LukeRJamieson/long-range-remote/previews/control_lite_3d_iso_back.png

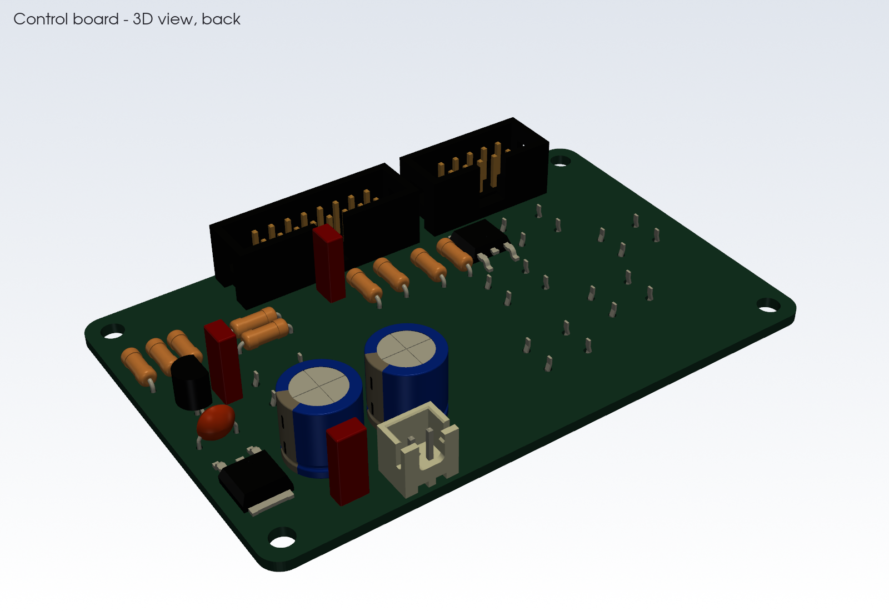
previews/control_lite_3d_iso_back.png
