LukeRJamieson/long-range-remote/previews/led_head_lite_3d_top.png

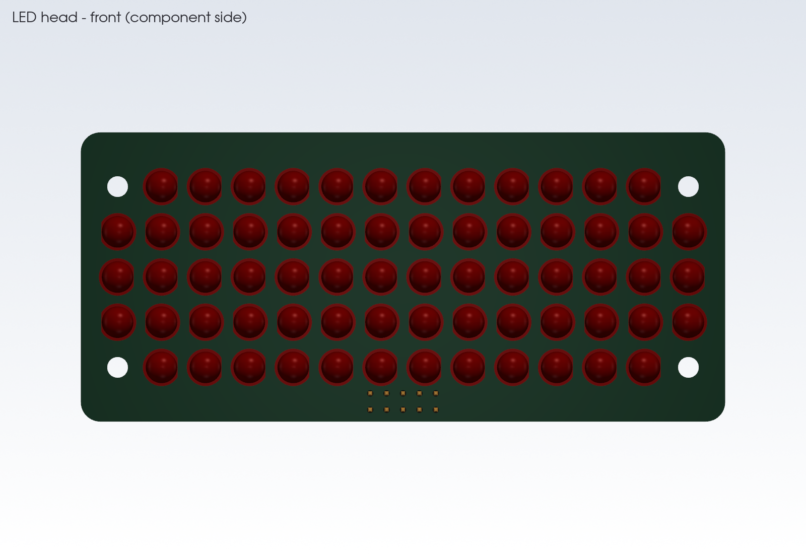
previews/led_head_lite_3d_top.png
