LukeRJamieson/long-range-remote/housing/previews/lite_bottom.png

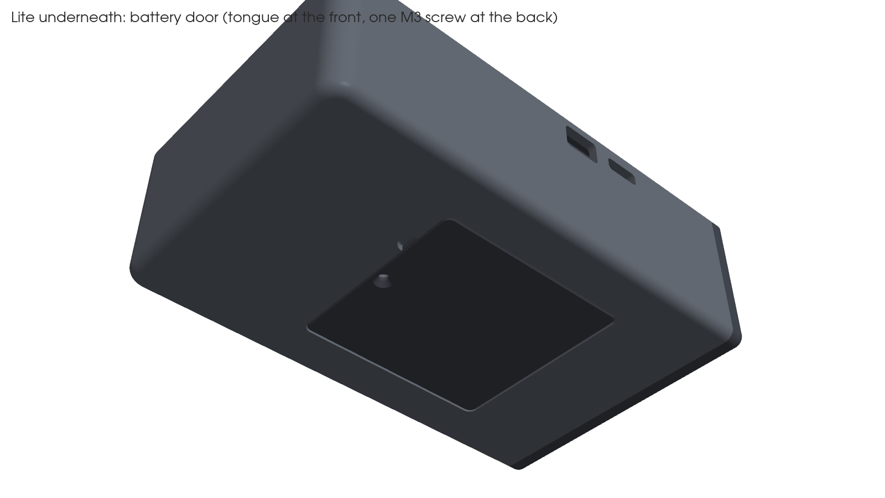
housing/previews/lite_bottom.png
