LukeRJamieson/long-range-remote/housing/previews/lite_display_buttons.png

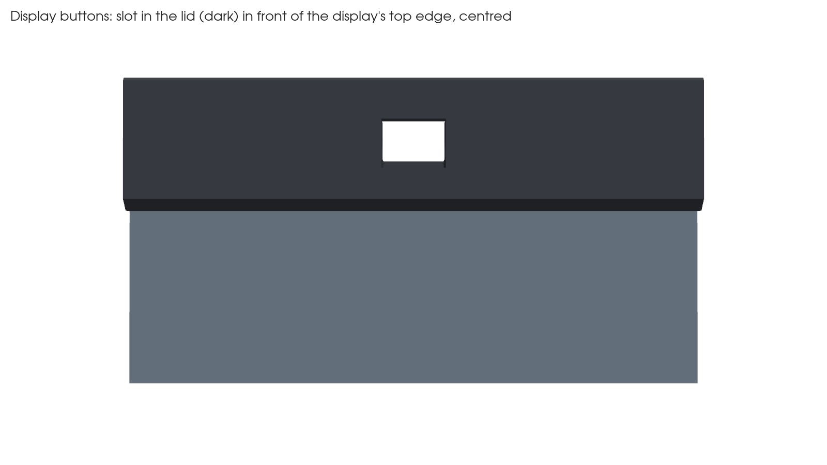
housing/previews/lite_display_buttons.png
