LukeRJamieson/long-range-remote/housing/previews/lite_exploded.png

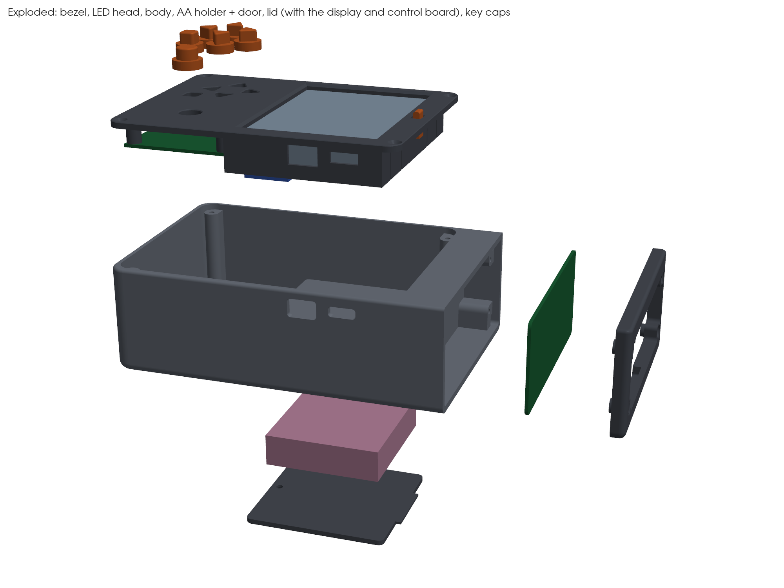
housing/previews/lite_exploded.png
