LukeRJamieson/long-range-remote/housing/previews/lite_front.png

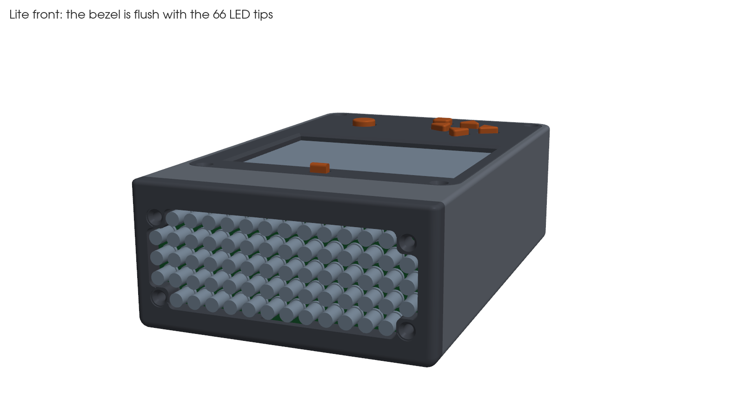
housing/previews/lite_front.png
