LukeRJamieson/long-range-remote/housing/previews/lite_keys.png

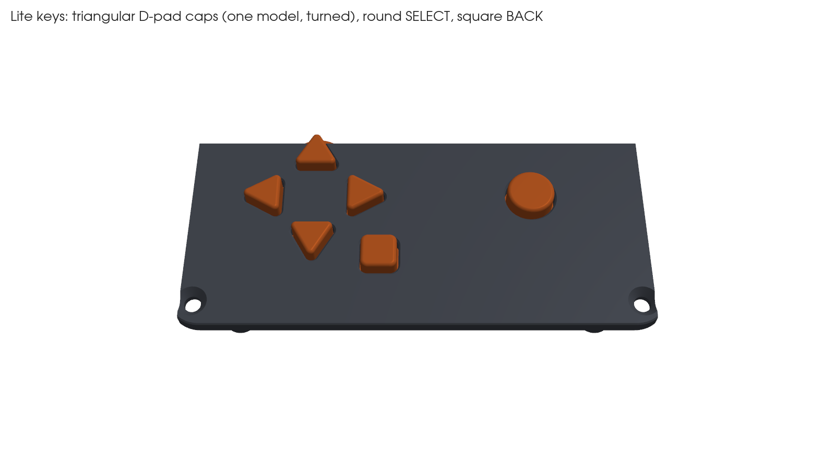
housing/previews/lite_keys.png
