LukeRJamieson/long-range-remote/housing/previews/lite_section.png

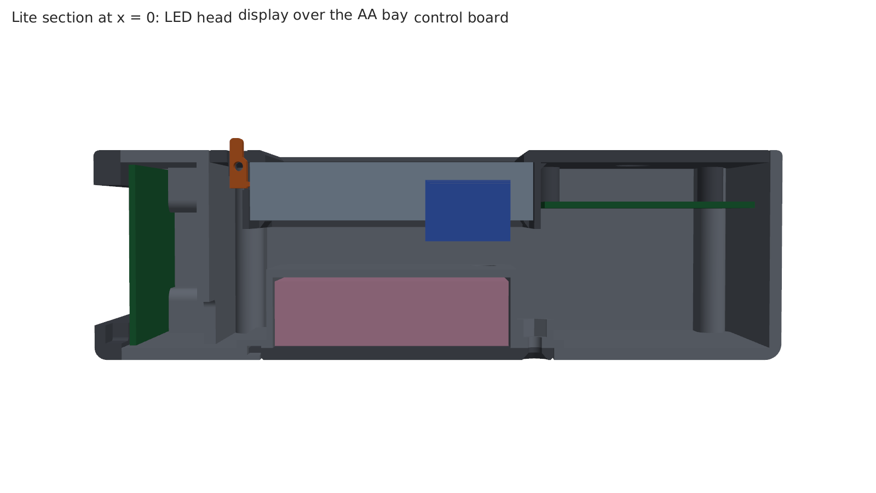
housing/previews/lite_section.png
