LukeRJamieson/long-range-remote/previews/control_lite_3d_bottom.png

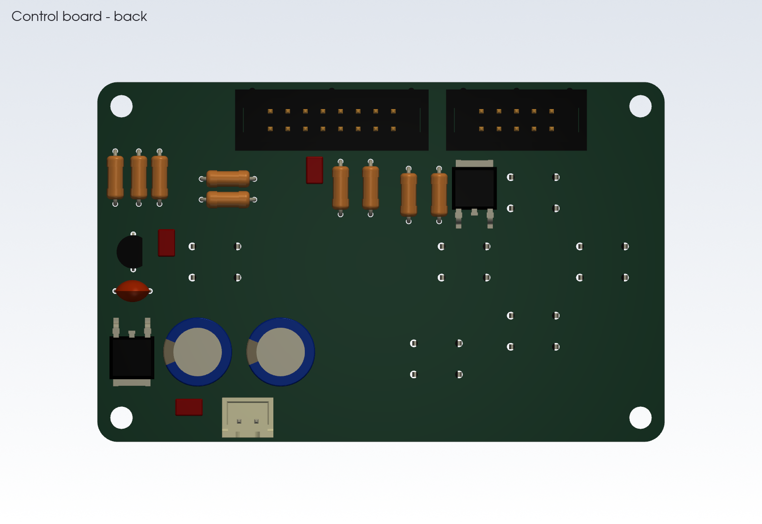
previews/control_lite_3d_bottom.png
