LukeRJamieson/long-range-remote/previews/control_lite_3d_iso.png

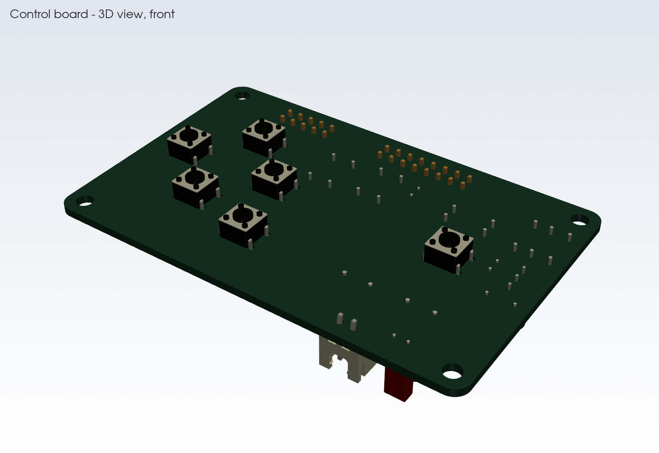
previews/control_lite_3d_iso.png
