LukeRJamieson/long-range-remote/previews/control_lite_3d_top.png

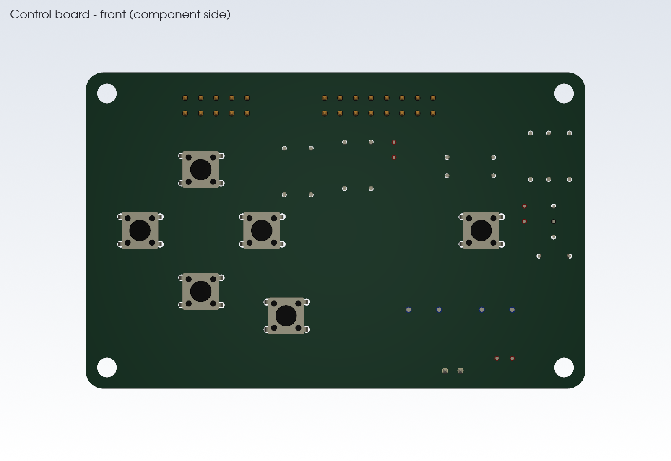
previews/control_lite_3d_top.png
