LukeRJamieson/long-range-remote/previews/control_lite_back.png

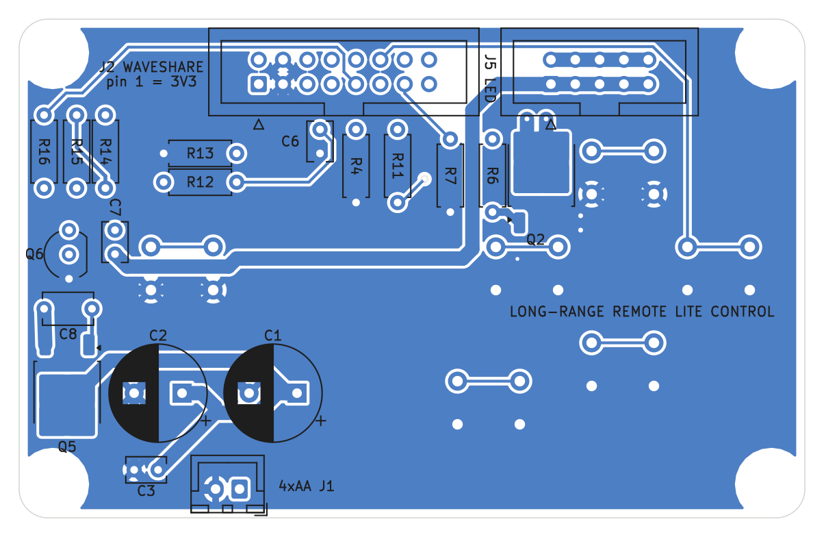
previews/control_lite_back.png
