LukeRJamieson/long-range-remote/previews/control_lite_front.png

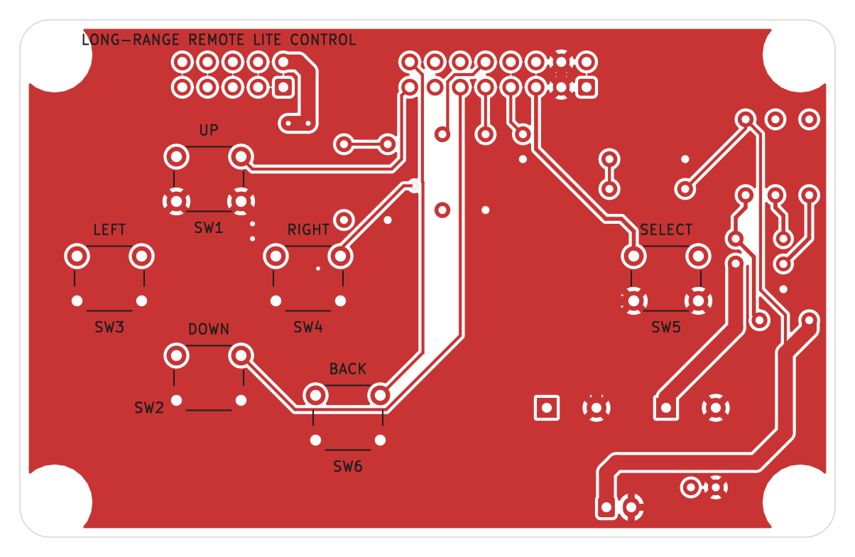
previews/control_lite_front.png
