LukeRJamieson/long-range-remote/previews/control_lite_schematic.png

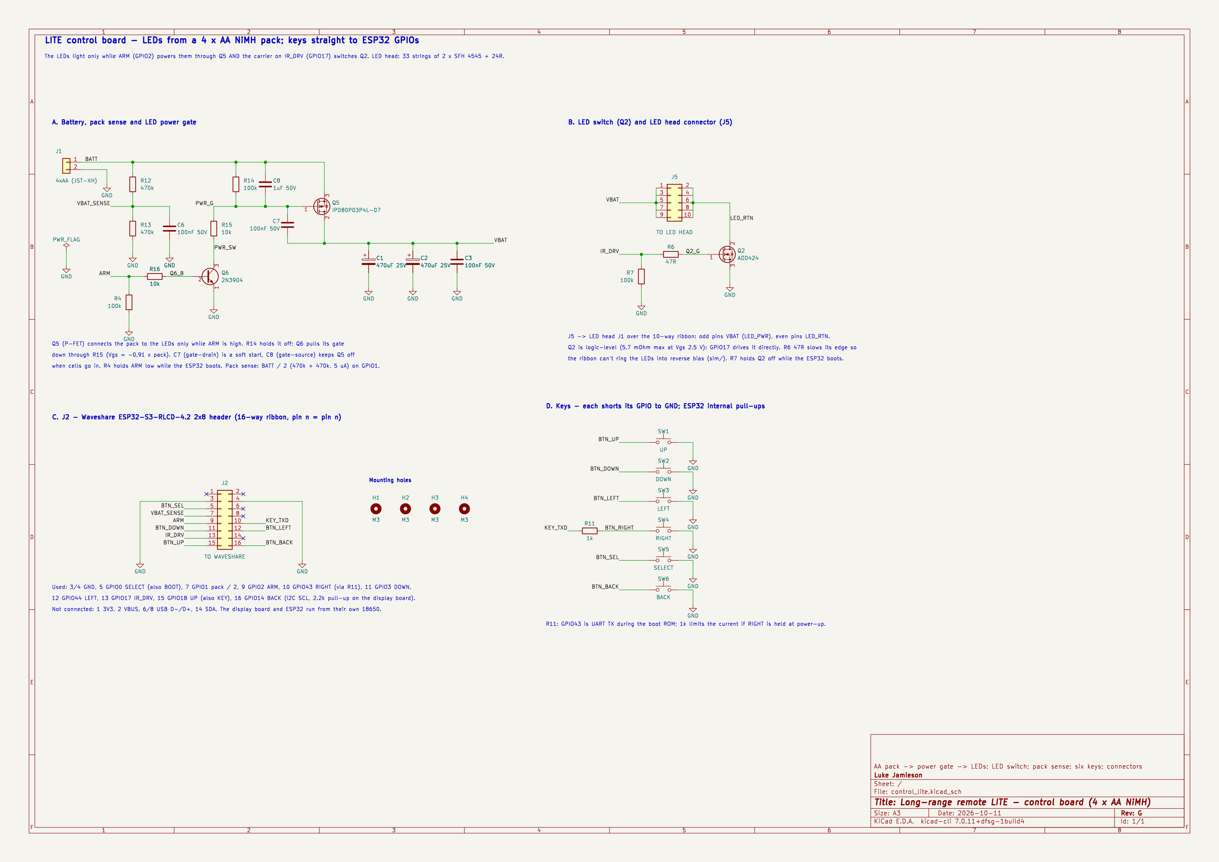
previews/control_lite_schematic.png
