LukeRJamieson/long-range-remote/previews/led_head_lite_3d_iso.png

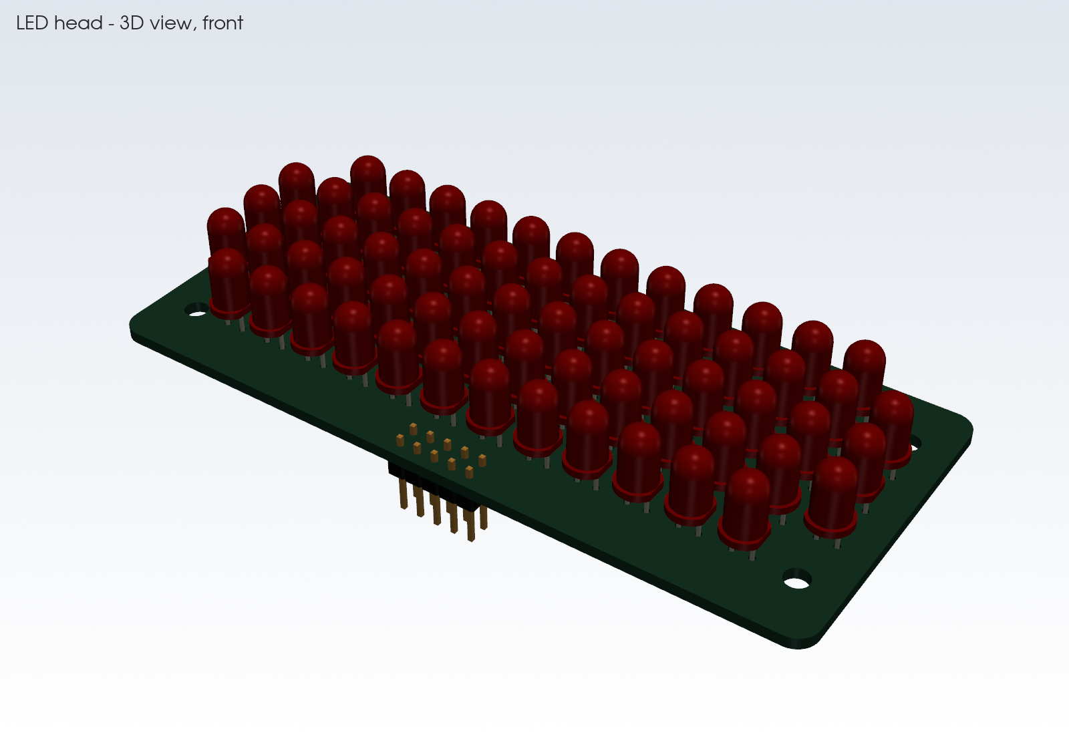
previews/led_head_lite_3d_iso.png
