LukeRJamieson/long-range-remote/previews/led_head_lite_3d_iso_back.png

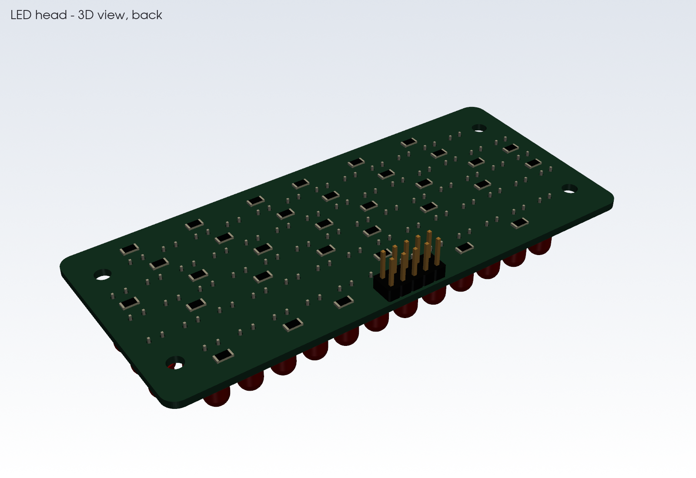
previews/led_head_lite_3d_iso_back.png
