LukeRJamieson/long-range-remote/previews/led_head_lite_back.png

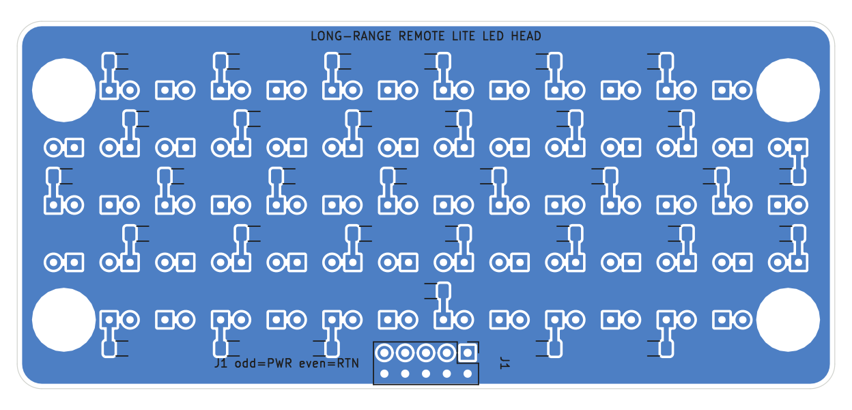
previews/led_head_lite_back.png
