LukeRJamieson/long-range-remote/previews/led_head_lite_front.png

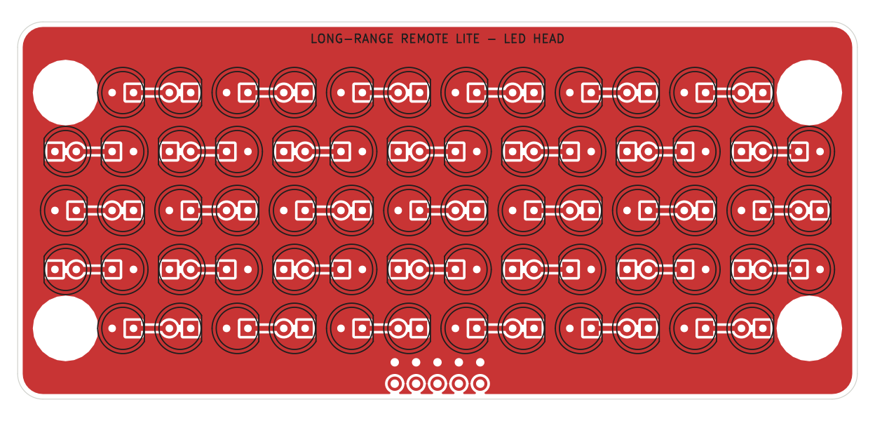
previews/led_head_lite_front.png
