LukeRJamieson/long-range-remote/previews/led_head_lite_schematic.png

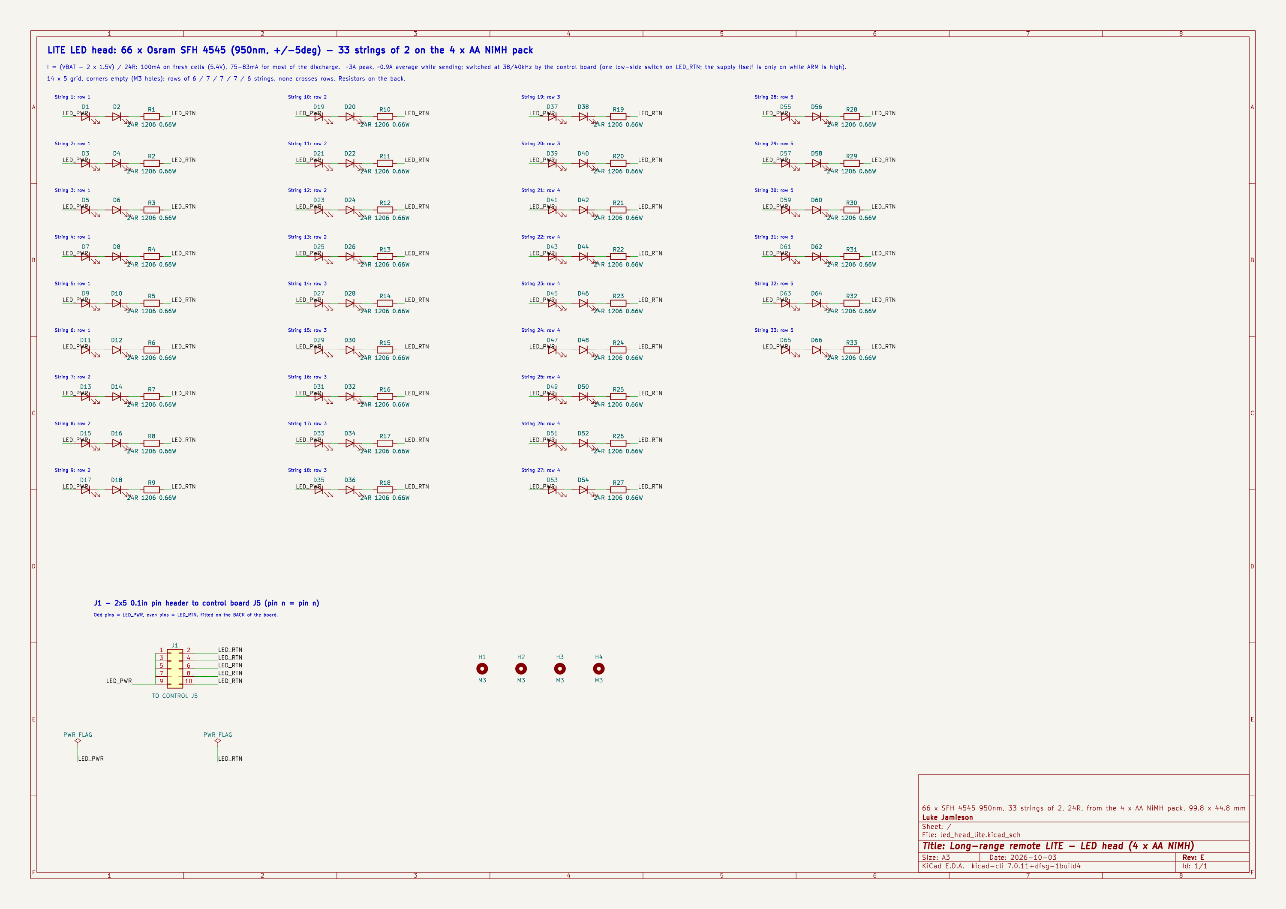
previews/led_head_lite_schematic.png
