LukeRJamieson/long-range-remote/housing/step_lite/long_range_remote_lite_housing_assembly.step

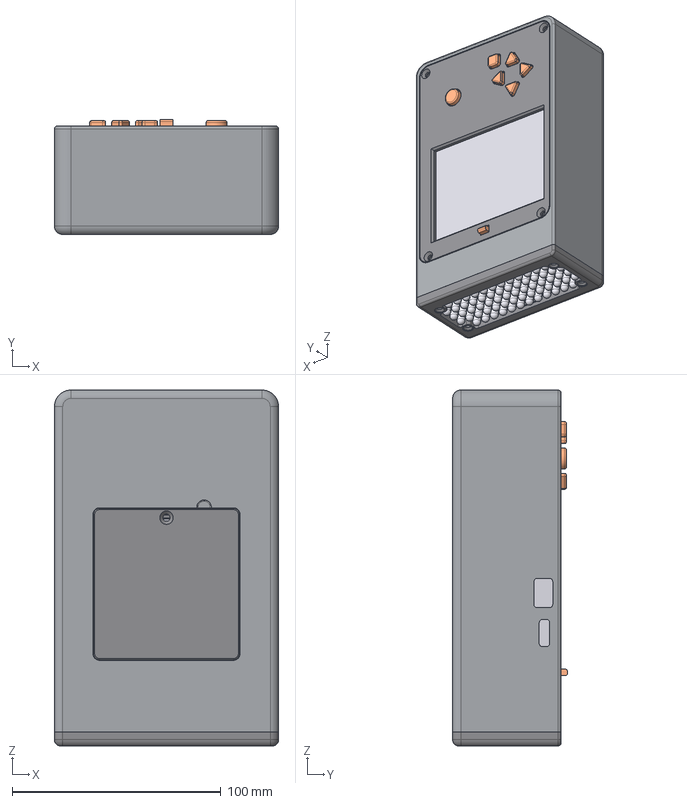
[picture p21: CAD file, 2026-10-23]
housing/step_lite/long_range_remote_lite_housing_assembly.step
107.4 x 55.0 x 170.5 mm
bezel
lid
door
pwr_lever
keycap_up
keycap_down
keycap_left
keycap_right
keycap_select
keycap_back
led_head_pcb
control_pcb
display
display_18650
display_18650_cell
display_header_socket
display_header_ribbon_socket
aa_holder
led_D1
led_D2
led_D3
led_D4
led_D5
led_D6
led_D7
led_D8
led_D9
led_D10
led_D11
led_D12
led_D13
led_D14
led_D15
led_D16
led_D17
led_D18
led_D19
led_D20
led_D21
led_D22
led_D23
led_D24
led_D25
led_D26
led_D27
led_D28
led_D29
led_D30
led_D31
led_D32
led_D33
led_D34
led_D35
led_D36
led_D37
led_D38
led_D39
led_D40
led_D41
led_D42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
