LukeRJamieson/long-range-remote/housing/step_lite/keycap_back.step

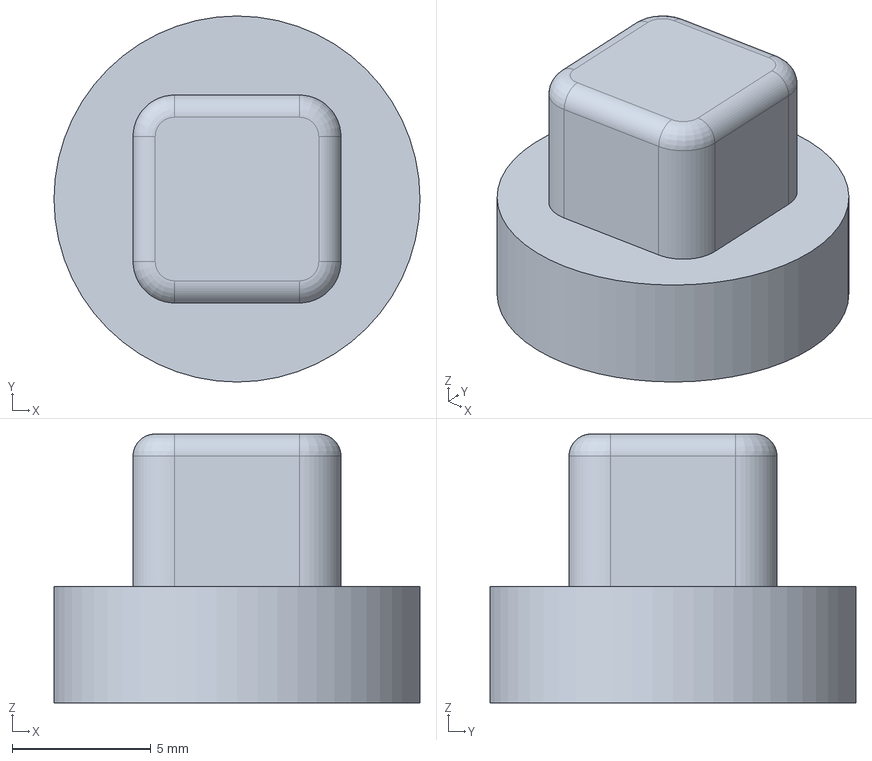
[picture p22: CAD file, 2026-10-23]
housing/step_lite/keycap_back.step
13.2 x 13.2 x 9.70 mm
