LukeRJamieson/long-range-remote/housing/stl_lite/body_bay_support_enforcer.stl

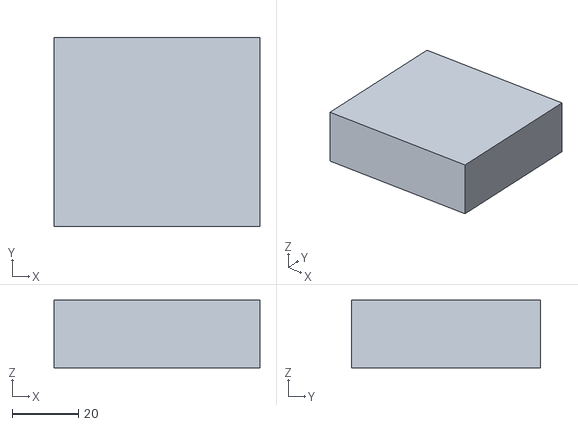
[picture p23: CAD file, 2026-10-17]
housing/stl_lite/body_bay_support_enforcer.stl
62.0 x 57.0 x 20.4
