LukeRJamieson/long-range-remote/housing/step_lite/door.step

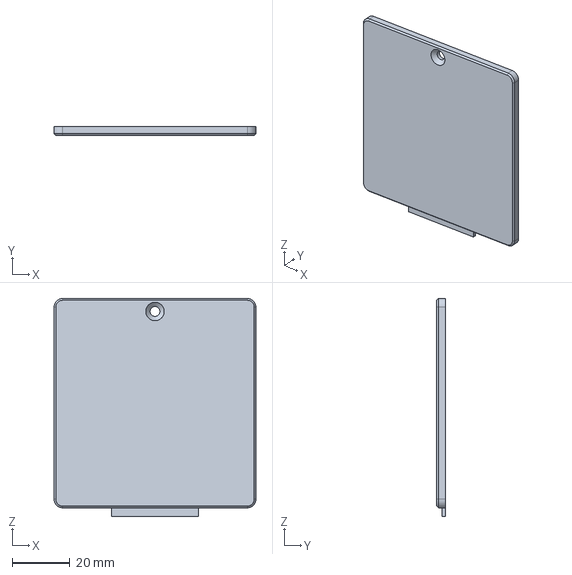
[picture p25: CAD file, 2026-10-23]
housing/step_lite/door.step
70.0 x 3.00 x 75.6 mm
