LukeRJamieson/long-range-remote/housing/step_lite/keycap_select.step

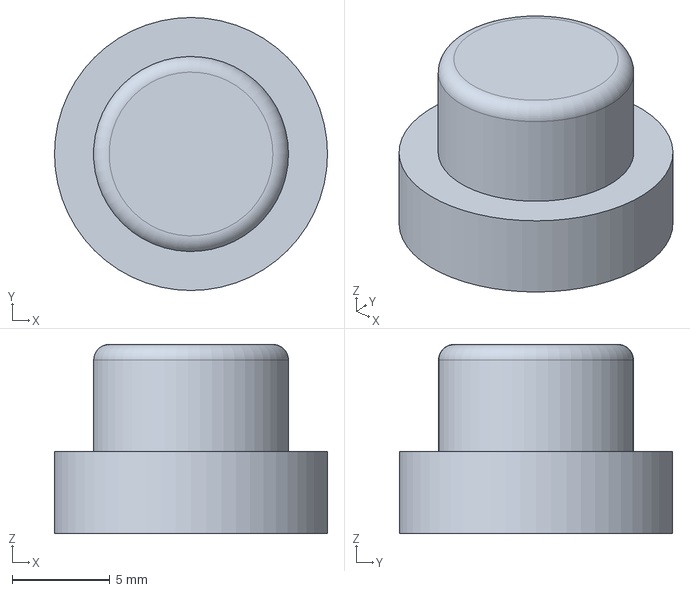
[picture p26: CAD file, 2026-10-23]
housing/step_lite/keycap_select.step
14.0 x 14.0 x 9.70 mm
