LukeRJamieson/long-range-remote/housing/step_lite/bezel.step

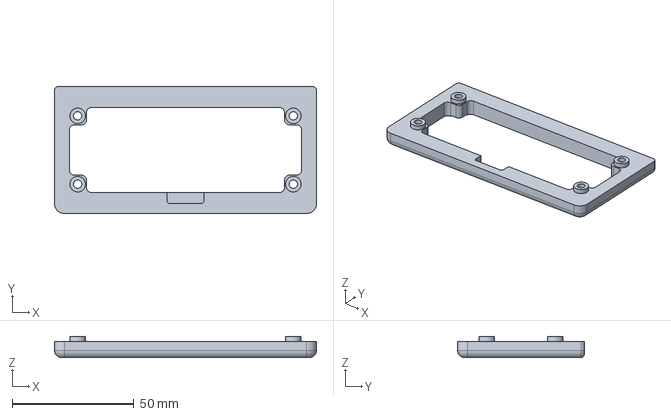
[picture p27: CAD file, 2026-10-23]
housing/step_lite/bezel.step
107.4 x 52.0 x 8.70 mm
