LukeRJamieson/long-range-remote/housing/step_lite/lid.step

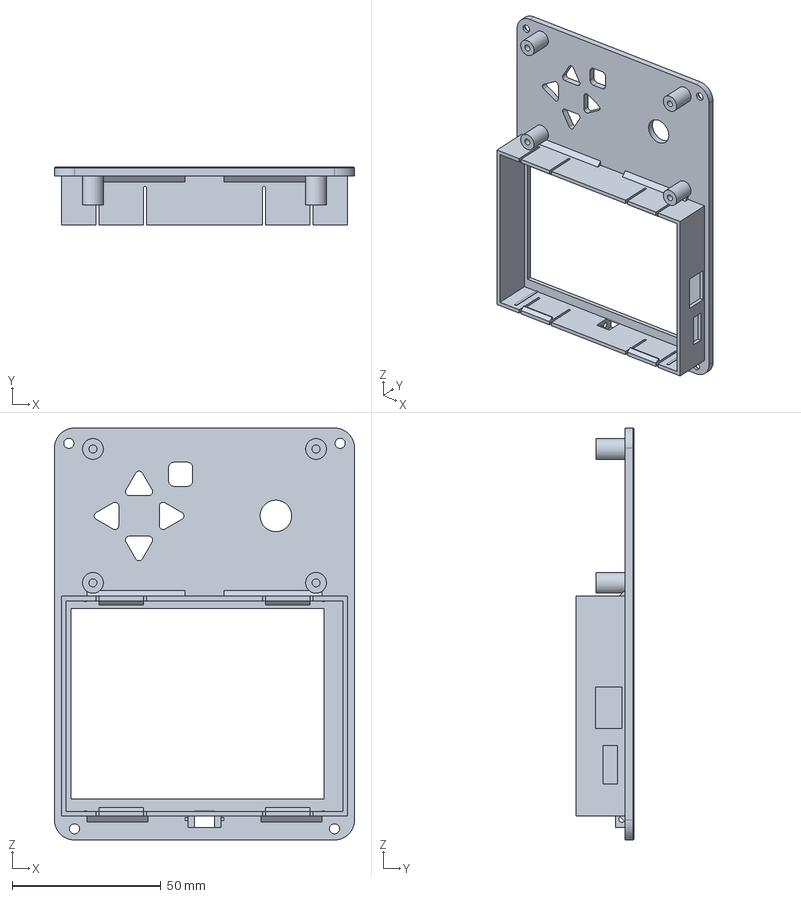
[picture p28: CAD file, 2026-10-23]
housing/step_lite/lid.step
100.9 x 19.5 x 138.5 mm
