LukeRJamieson/long-range-remote/housing/step_lite/pwr_lever.step

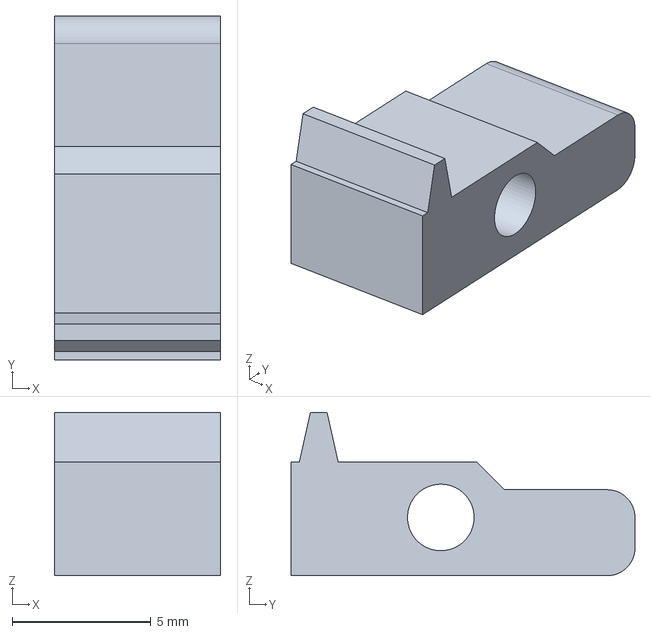
[picture p29: CAD file, 2026-10-23]
housing/step_lite/pwr_lever.step
6.00 x 12.4 x 5.89 mm
