LukeRJamieson/long-range-remote/housing/step_lite/body.step

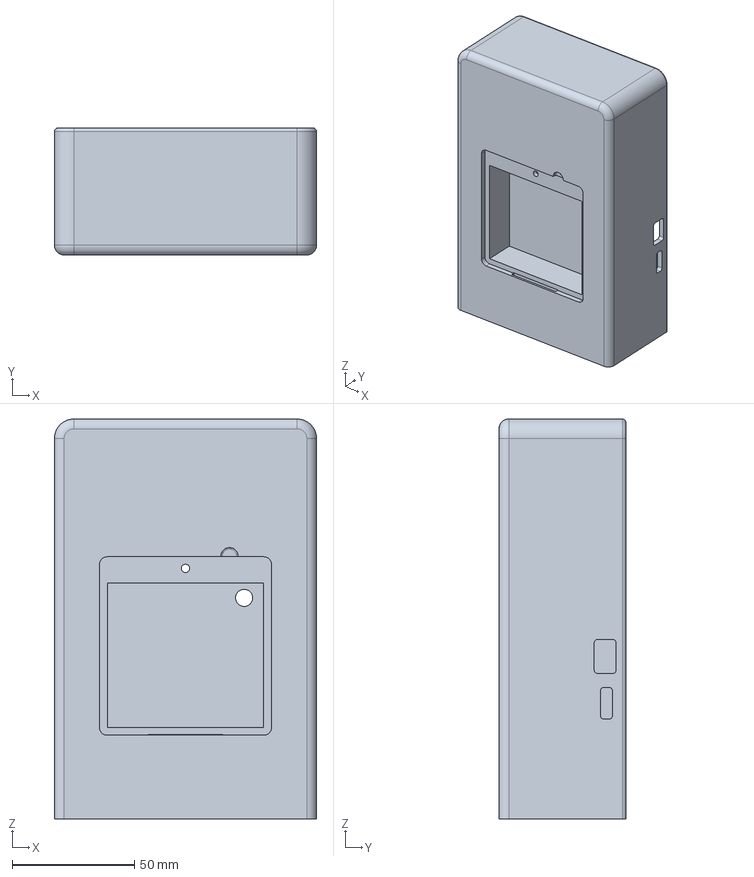
[picture p30: CAD file, 2026-10-23]
housing/step_lite/body.step
107.4 x 52.0 x 163.8 mm
