LukeRJamieson/long-range-remote/(list of files, cad)

Other CAD files:
housing/stl_lite/bezel.stl
housing/stl_lite/body.stl
housing/stl_lite/door.stl
housing/stl_lite/keycap_back.stl
housing/stl_lite/keycap_dpad.stl
housing/stl_lite/keycap_select.stl
housing/stl_lite/lid.stl
housing/stl_lite/pwr_lever.stl
