LukeRJamieson/long-range-remote/control_lite/build/control_lite_back_cu.png

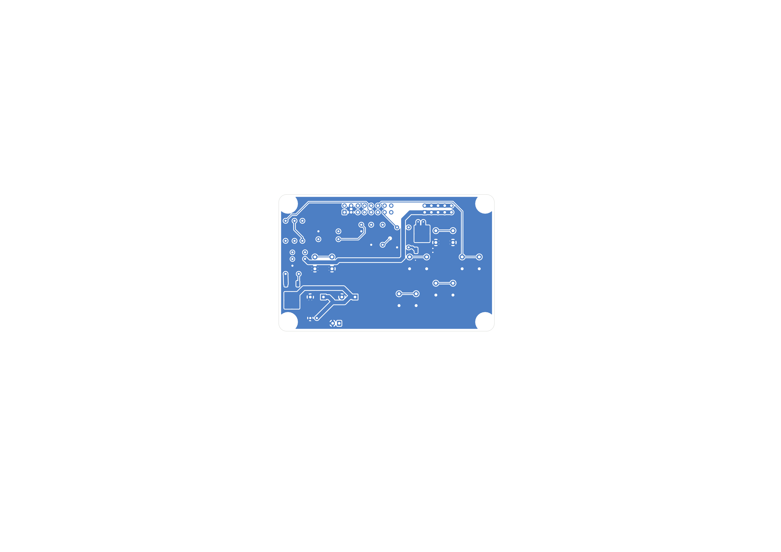
control_lite/build/control_lite_back_cu.png
