LukeRJamieson/long-range-remote/housing/previews/lite_assembled.png

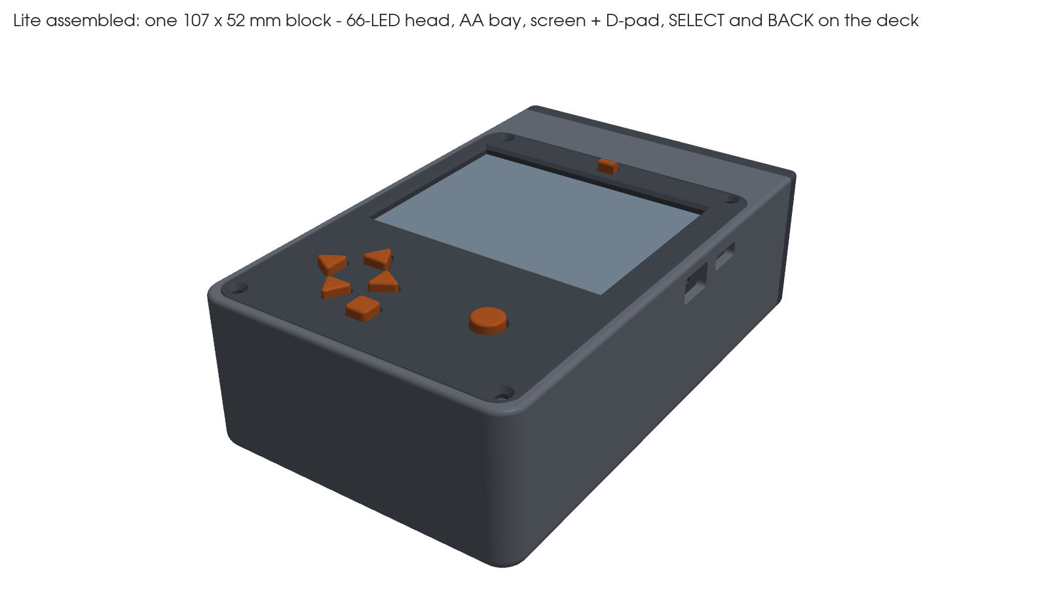
housing/previews/lite_assembled.png
