LukeRJamieson/long-range-remote/housing/previews/lite_print_orientation.png

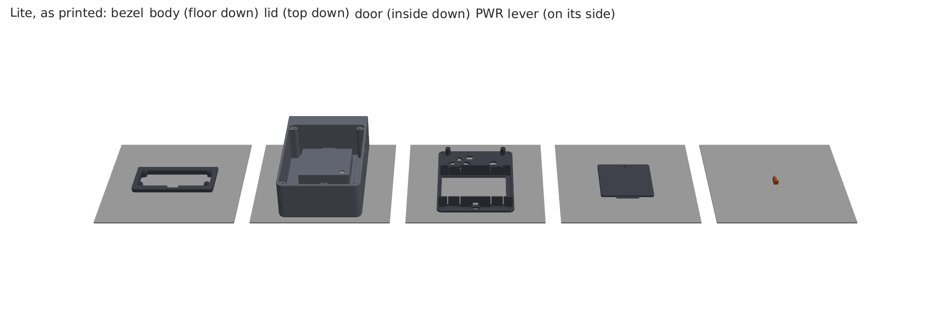
housing/previews/lite_print_orientation.png
