LukeRJamieson/long-range-remote/led_head_lite/build/led_head_lite_back_silk.png

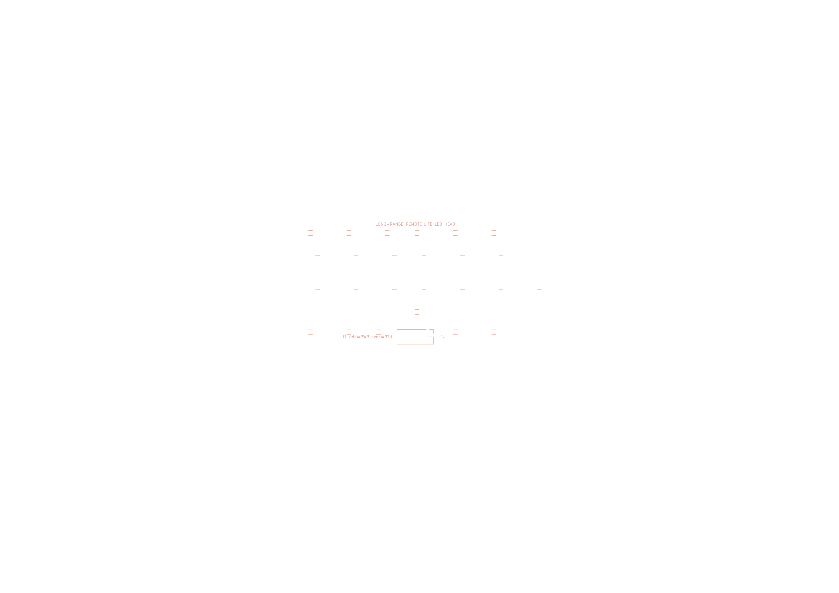
led_head_lite/build/led_head_lite_back_silk.png
