LukeRJamieson/long-range-remote/led_head_lite/build/led_head_lite_front_silk.png

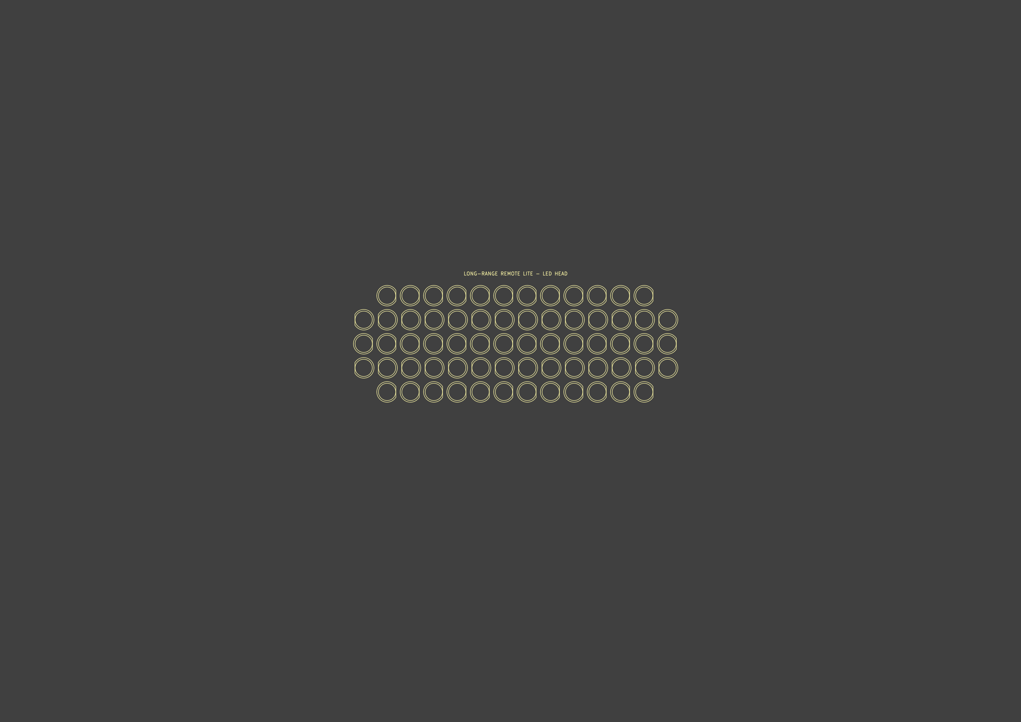
led_head_lite/build/led_head_lite_front_silk.png
