LukeRJamieson/long-range-remote/pdf/control_lite_schematic.pdf

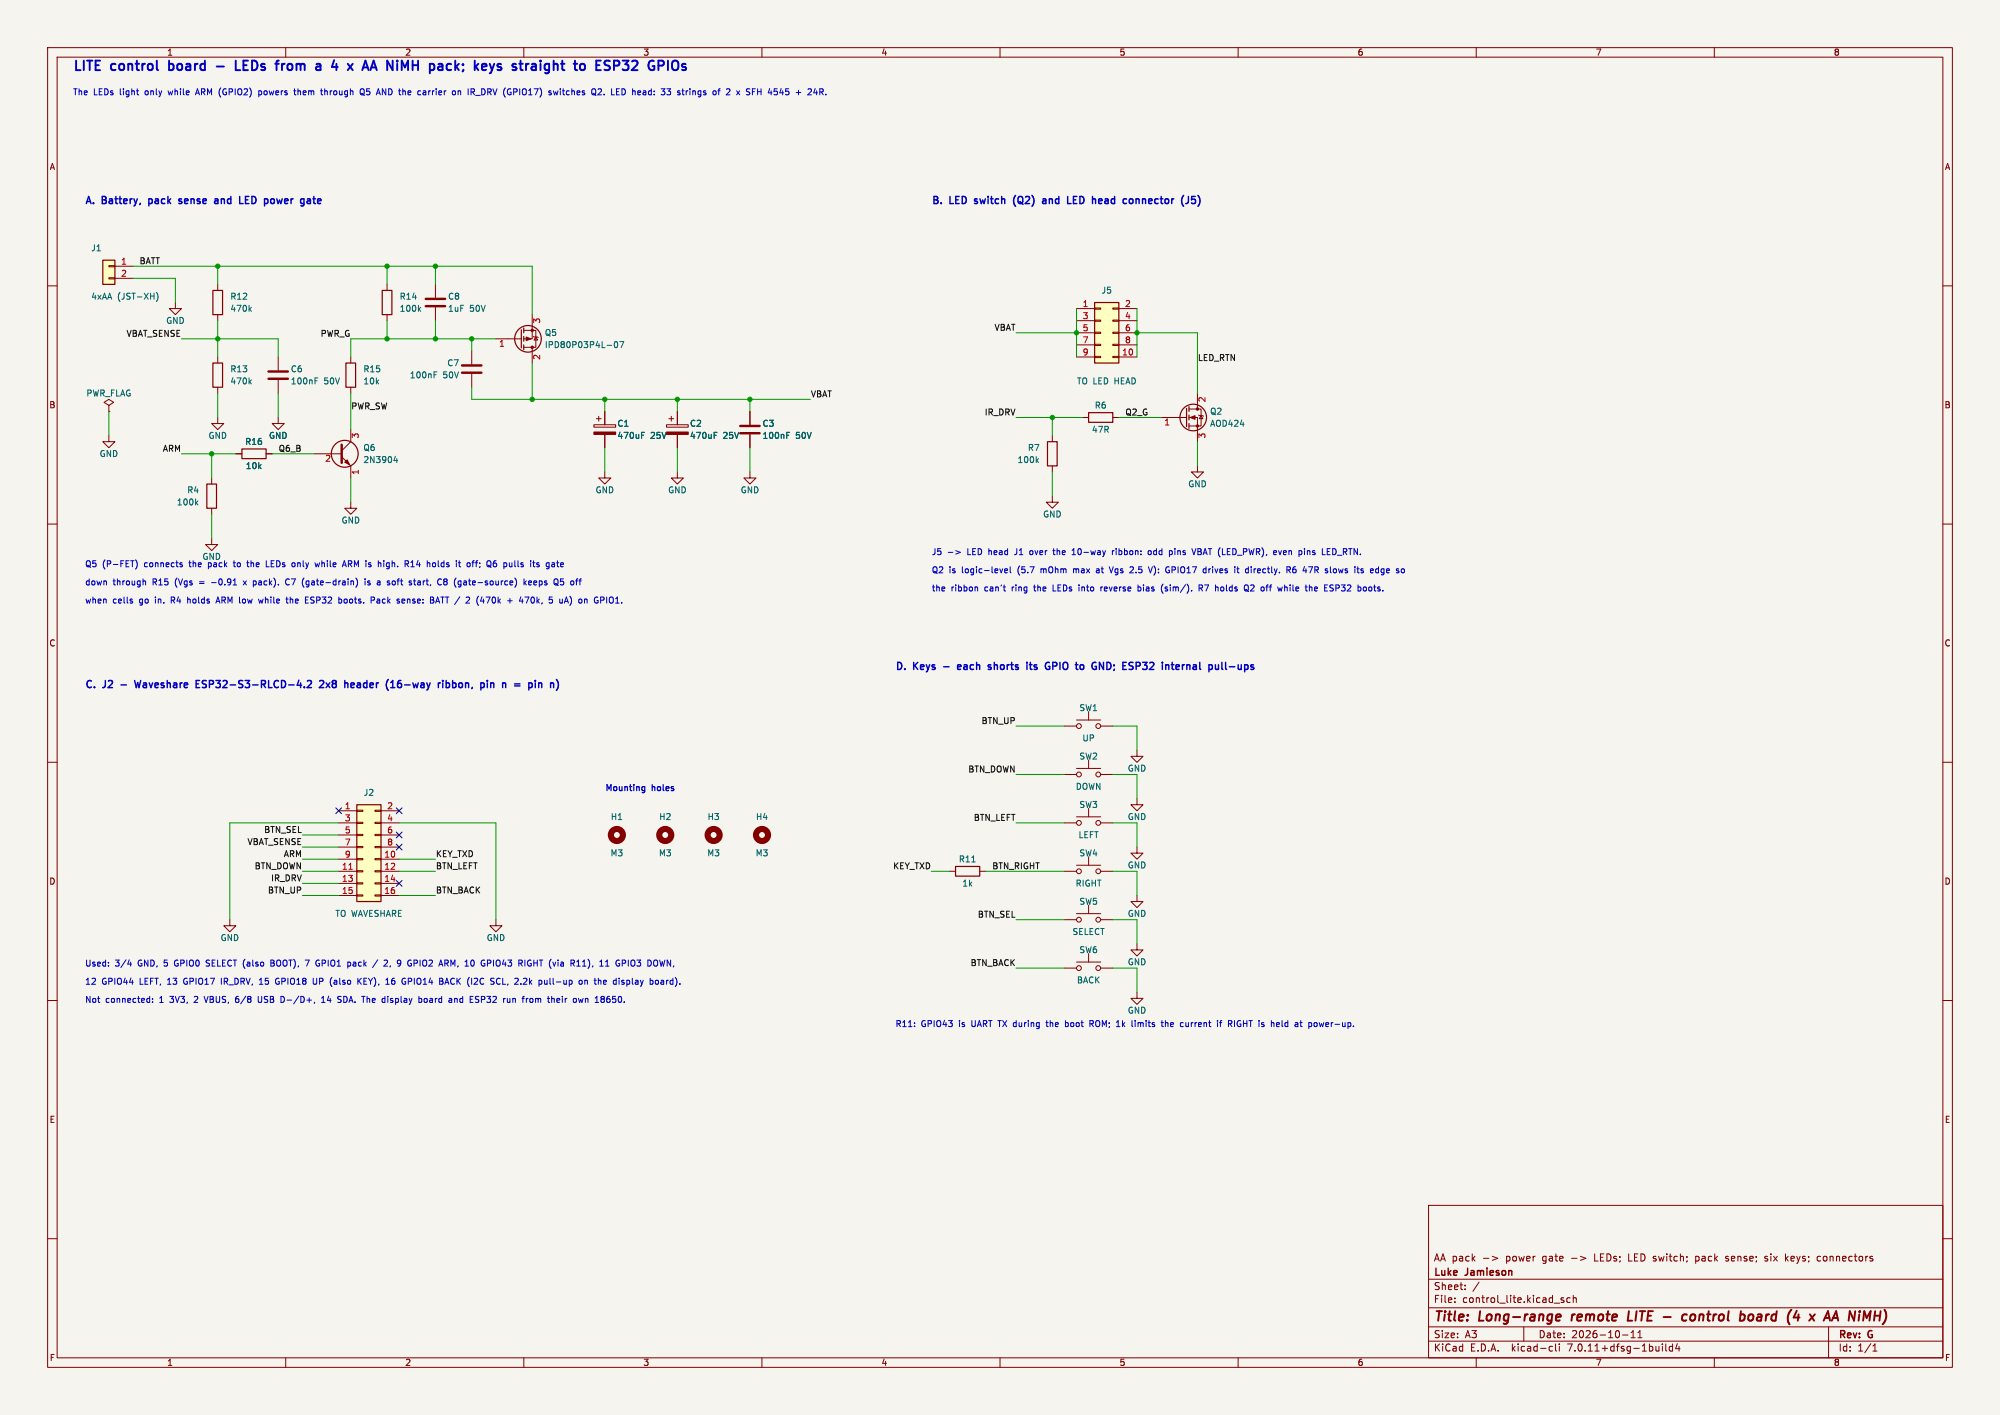
[picture p49: page 1]

LITE control board - LEDs from a 4 x AA NiMH pack; keys straight to ESP32 GPIOs

A. Battery, pack sense and LED power gate

Mounting holes Used: 3/4 GND, 5 GPIO0 SELECT (also BOOT), 7 GPIO1 pack / 2, 9 GPIO2 ARM, 10 GPIO43 RIGHT (via R11), 11 GPIO3 DOWN,
