LukeRJamieson/long-range-remote/pdf/control_lite_pcb.pdf

# Long-range remote - Control board, 4 x AA (82 x 52 mm)

## Top: copper + silkscreen (scale 3.23:1, board outline 82.0 x 52.0 mm)

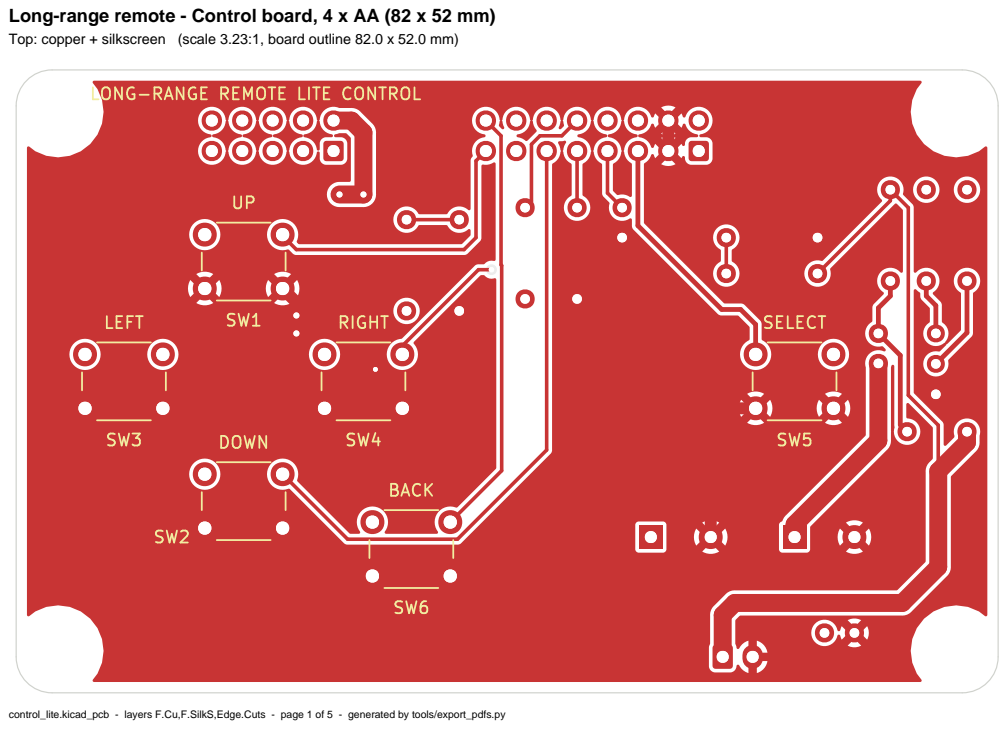
[picture p50: page 1]

control_lite.kicad_pcb - layers F.Cu,F.SilkS,Edge.Cuts - page 1 of 5 - generated by tools/export_pdfs.py

Bottom: copper + silkscreen (mirrored, as seen from the back) (scale 3.23:1, board outline 82.0 x 52.0 mm)

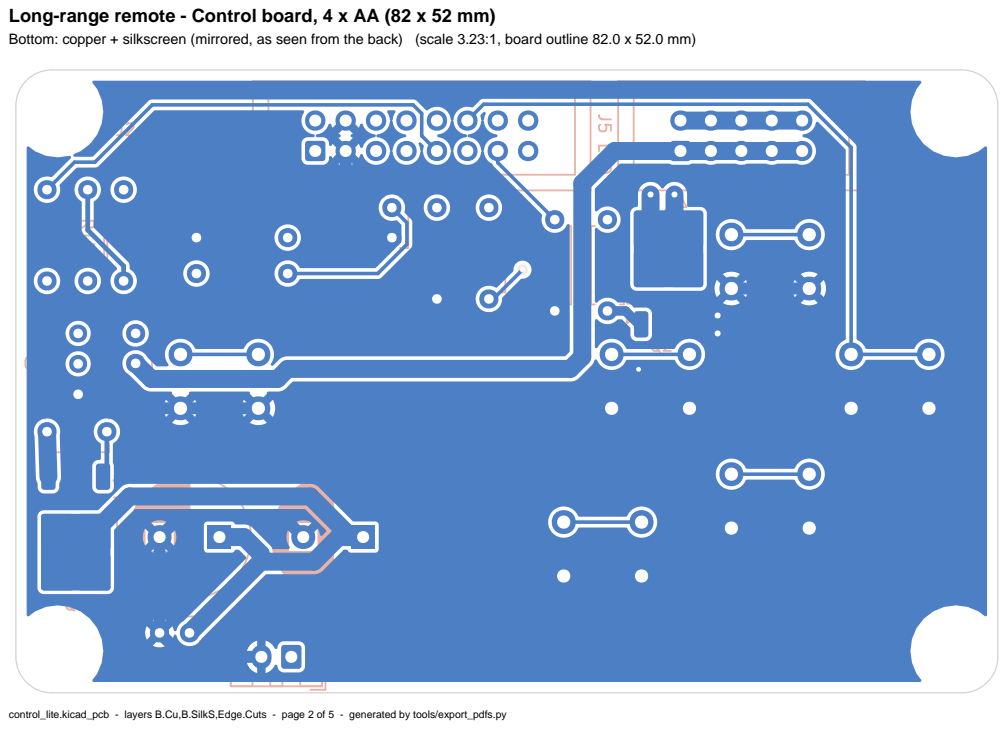
[picture p51: page 2]

control_lite.kicad_pcb - layers B.Cu,B.SilkS,Edge.Cuts - page 2 of 5 - generated by tools/export_pdfs.py

Top assembly: part outlines, references, values (scale 3.23:1, board outline 82.0 x 52.0 mm)

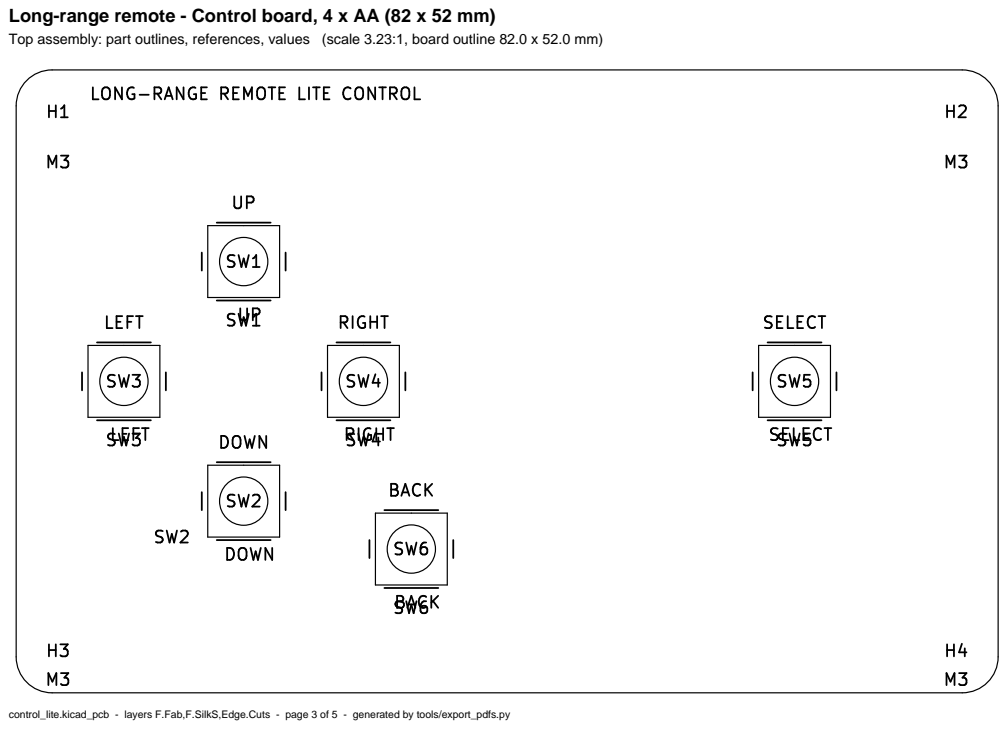
[picture p52: page 3]

control_lite.kicad_pcb - layers F.Fab,F.SilkS,Edge.Cuts - page 3 of 5 - generated by tools/export_pdfs.py

Bottom assembly (mirrored, as seen from the back) (scale 3.23:1, board outline 82.0 x 52.0 mm)

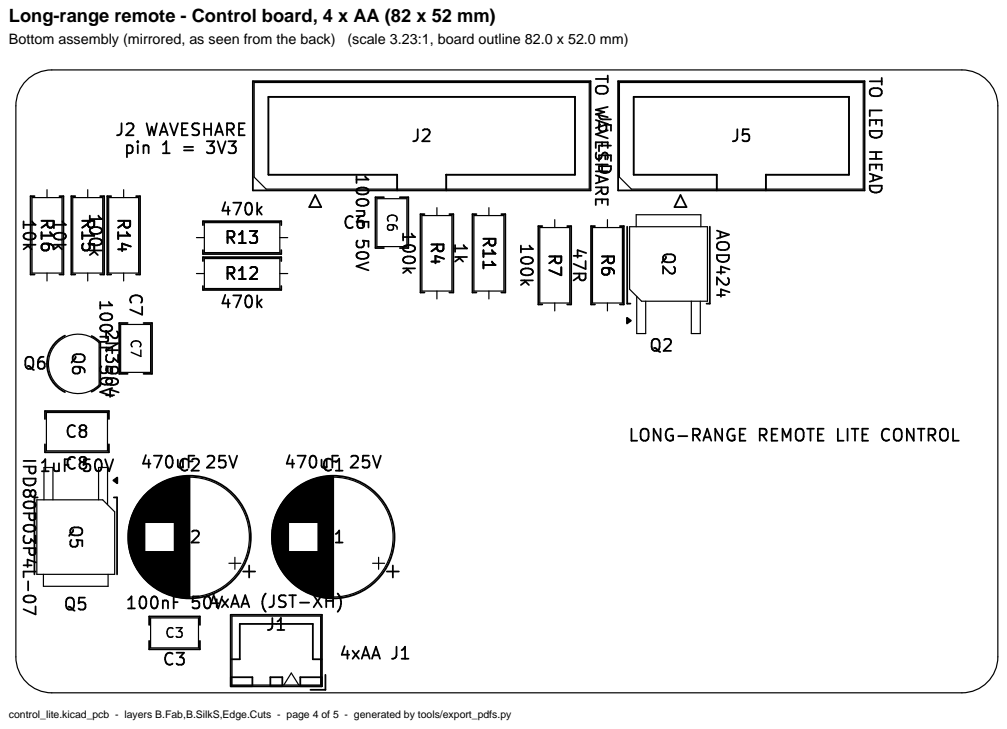
[picture p53: page 4]

control_lite.kicad_pcb - layers B.Fab,B.SilkS,Edge.Cuts - page 4 of 5 - generated by tools/export_pdfs.py

Top assembly at 1:1 - print at 100 % / actual size (scale 1:1, board outline 82.0 x 52.0 mm)

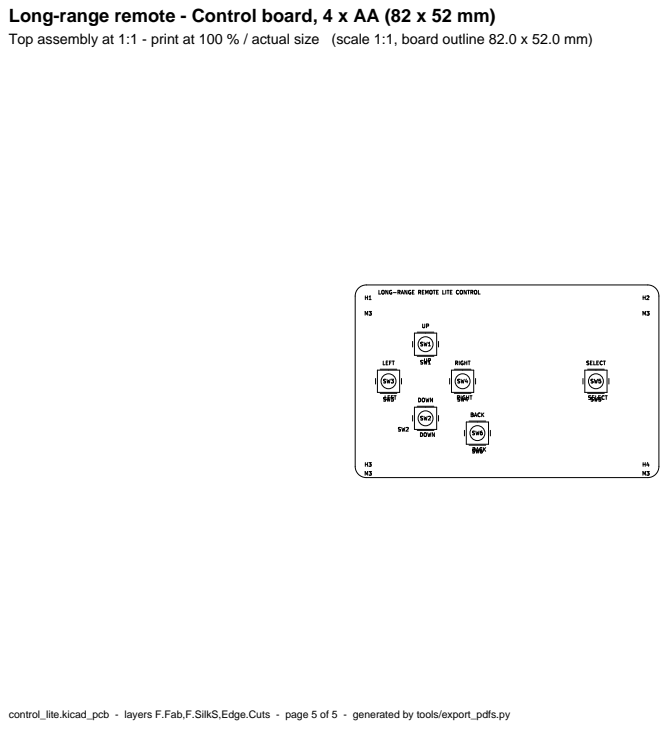
[picture p54: page 5]

control_lite.kicad_pcb - layers F.Fab,F.SilkS,Edge.Cuts - page 5 of 5 - generated by tools/export_pdfs.py
