LukeRJamieson/long-range-remote/pdf/led_head_lite_pcb.pdf

# Long-range remote - LED head, 66 x SFH 4545 on 4 x AA (99.8 x 44.8 mm)

## Top: copper + silkscreen (scale 2.69:1, board outline 99.8 x 44.8 mm)

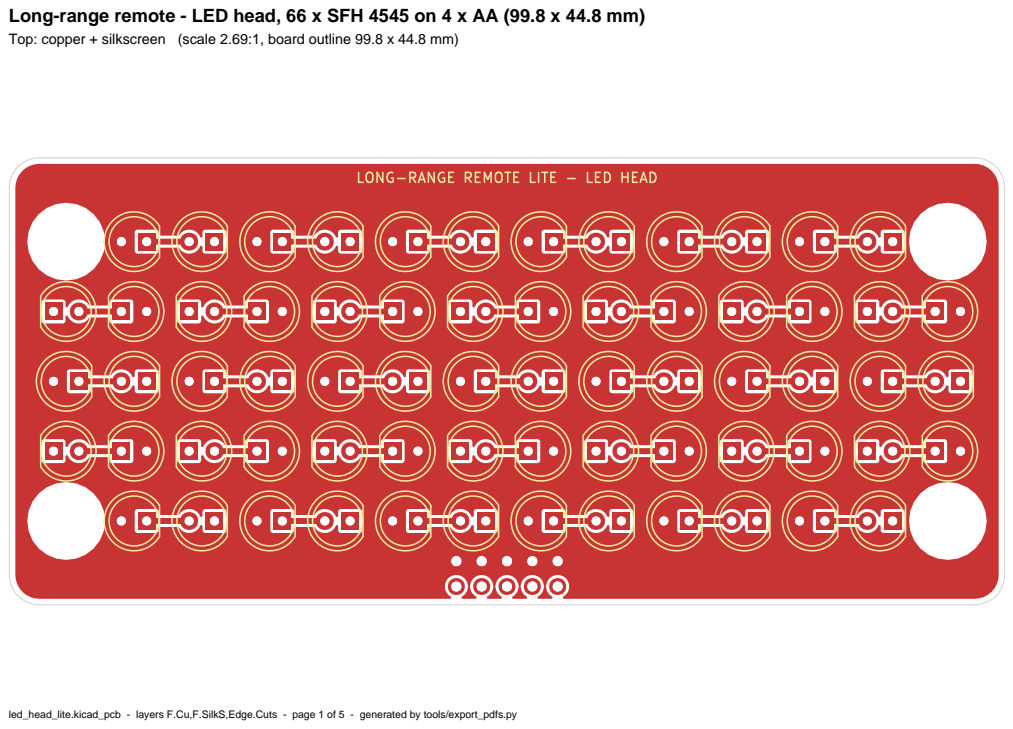
[picture p55: page 1]

led_head_lite.kicad_pcb - layers F.Cu,F.SilkS,Edge.Cuts - page 1 of 5 - generated by tools/export_pdfs.py

Bottom: copper + silkscreen (mirrored, as seen from the back) (scale 2.69:1, board outline 99.8 x 44.8 mm)

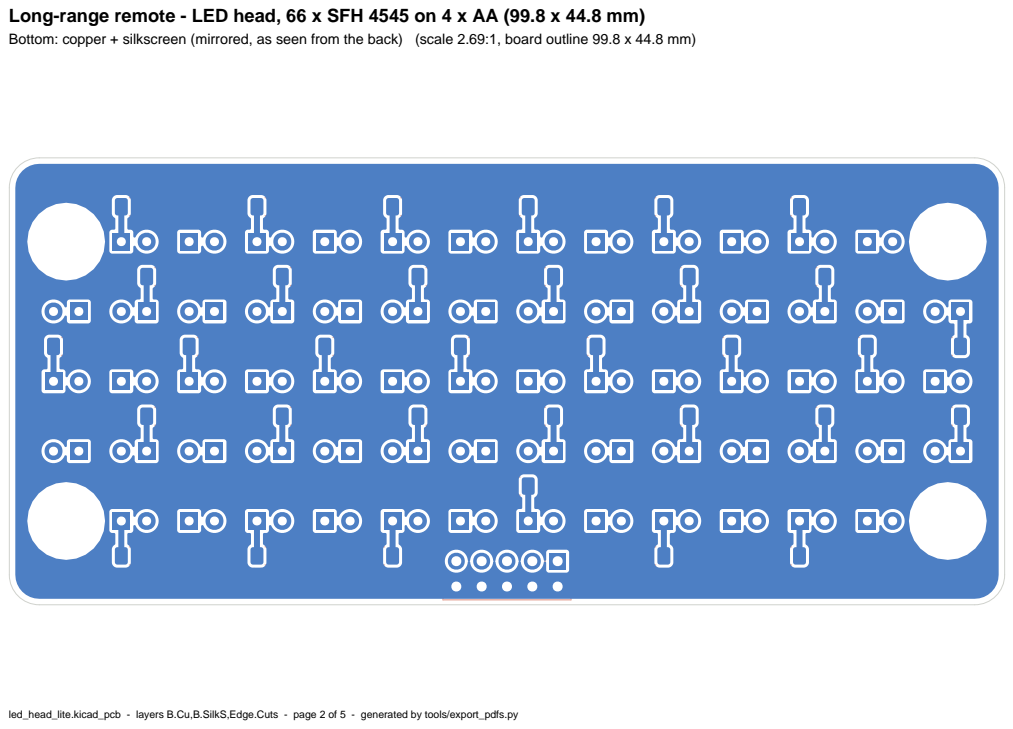
[picture p56: page 2]

led_head_lite.kicad_pcb - layers B.Cu,B.SilkS,Edge.Cuts - page 2 of 5 - generated by tools/export_pdfs.py

Top assembly: part outlines, references, values (scale 2.69:1, board outline 99.8 x 44.8 mm)

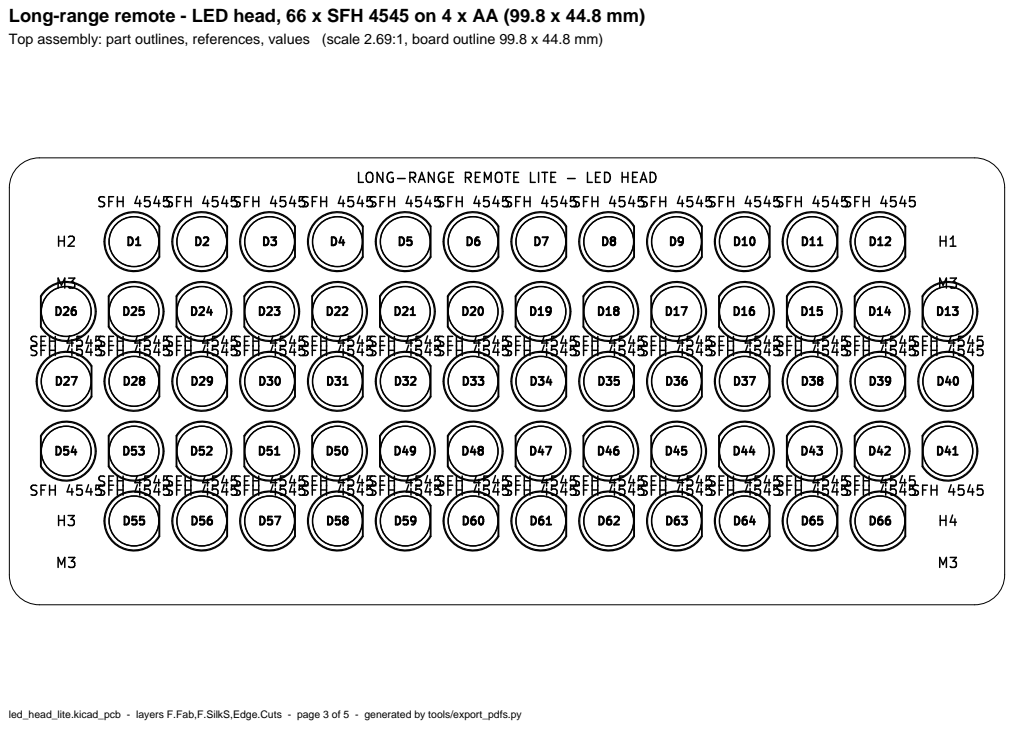
[picture p57: page 3]

led_head_lite.kicad_pcb - layers F.Fab,F.SilkS,Edge.Cuts - page 3 of 5 - generated by tools/export_pdfs.py

Bottom assembly (mirrored, as seen from the back) (scale 2.69:1, board outline 99.8 x 44.8 mm)

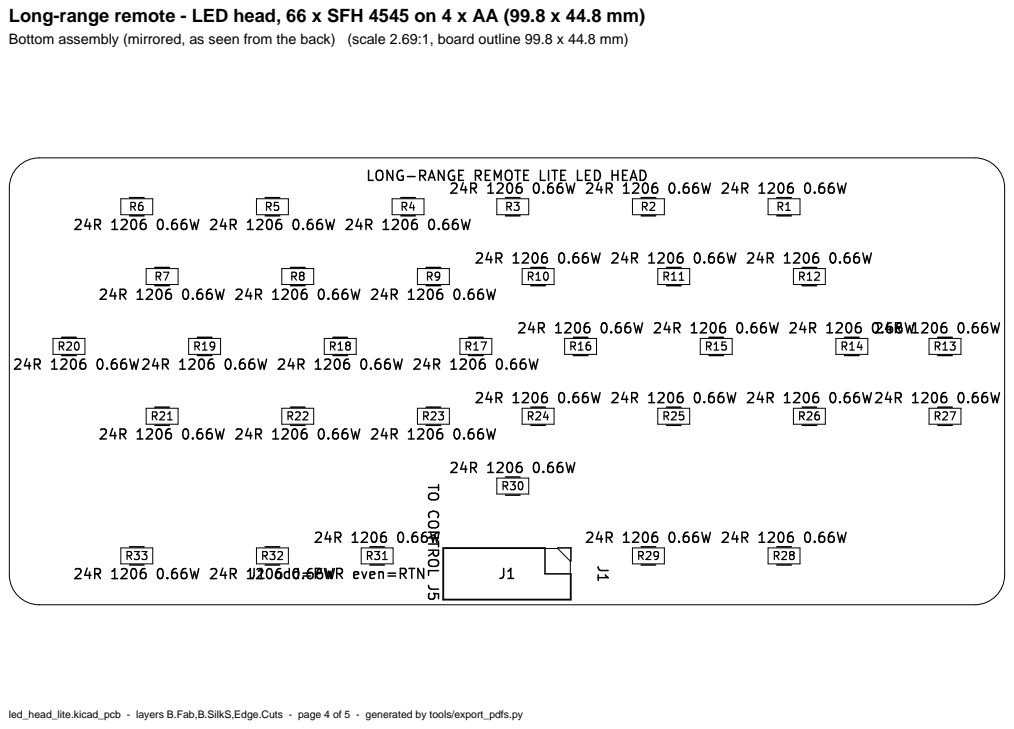
[picture p58: page 4]

led_head_lite.kicad_pcb - layers B.Fab,B.SilkS,Edge.Cuts - page 4 of 5 - generated by tools/export_pdfs.py

Top assembly at 1:1 - print at 100 % / actual size (scale 1:1, board outline 99.8 x 44.8 mm)

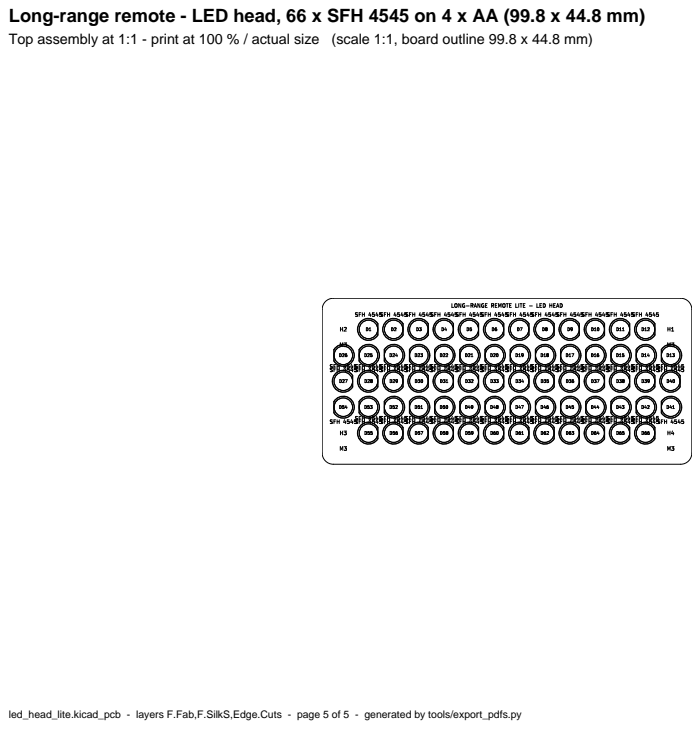
[picture p59: page 5]

led_head_lite.kicad_pcb - layers F.Fab,F.SilkS,Edge.Cuts - page 5 of 5 - generated by tools/export_pdfs.py
