LukeRJamieson/long-range-remote/pdf/led_head_lite_schematic.pdf

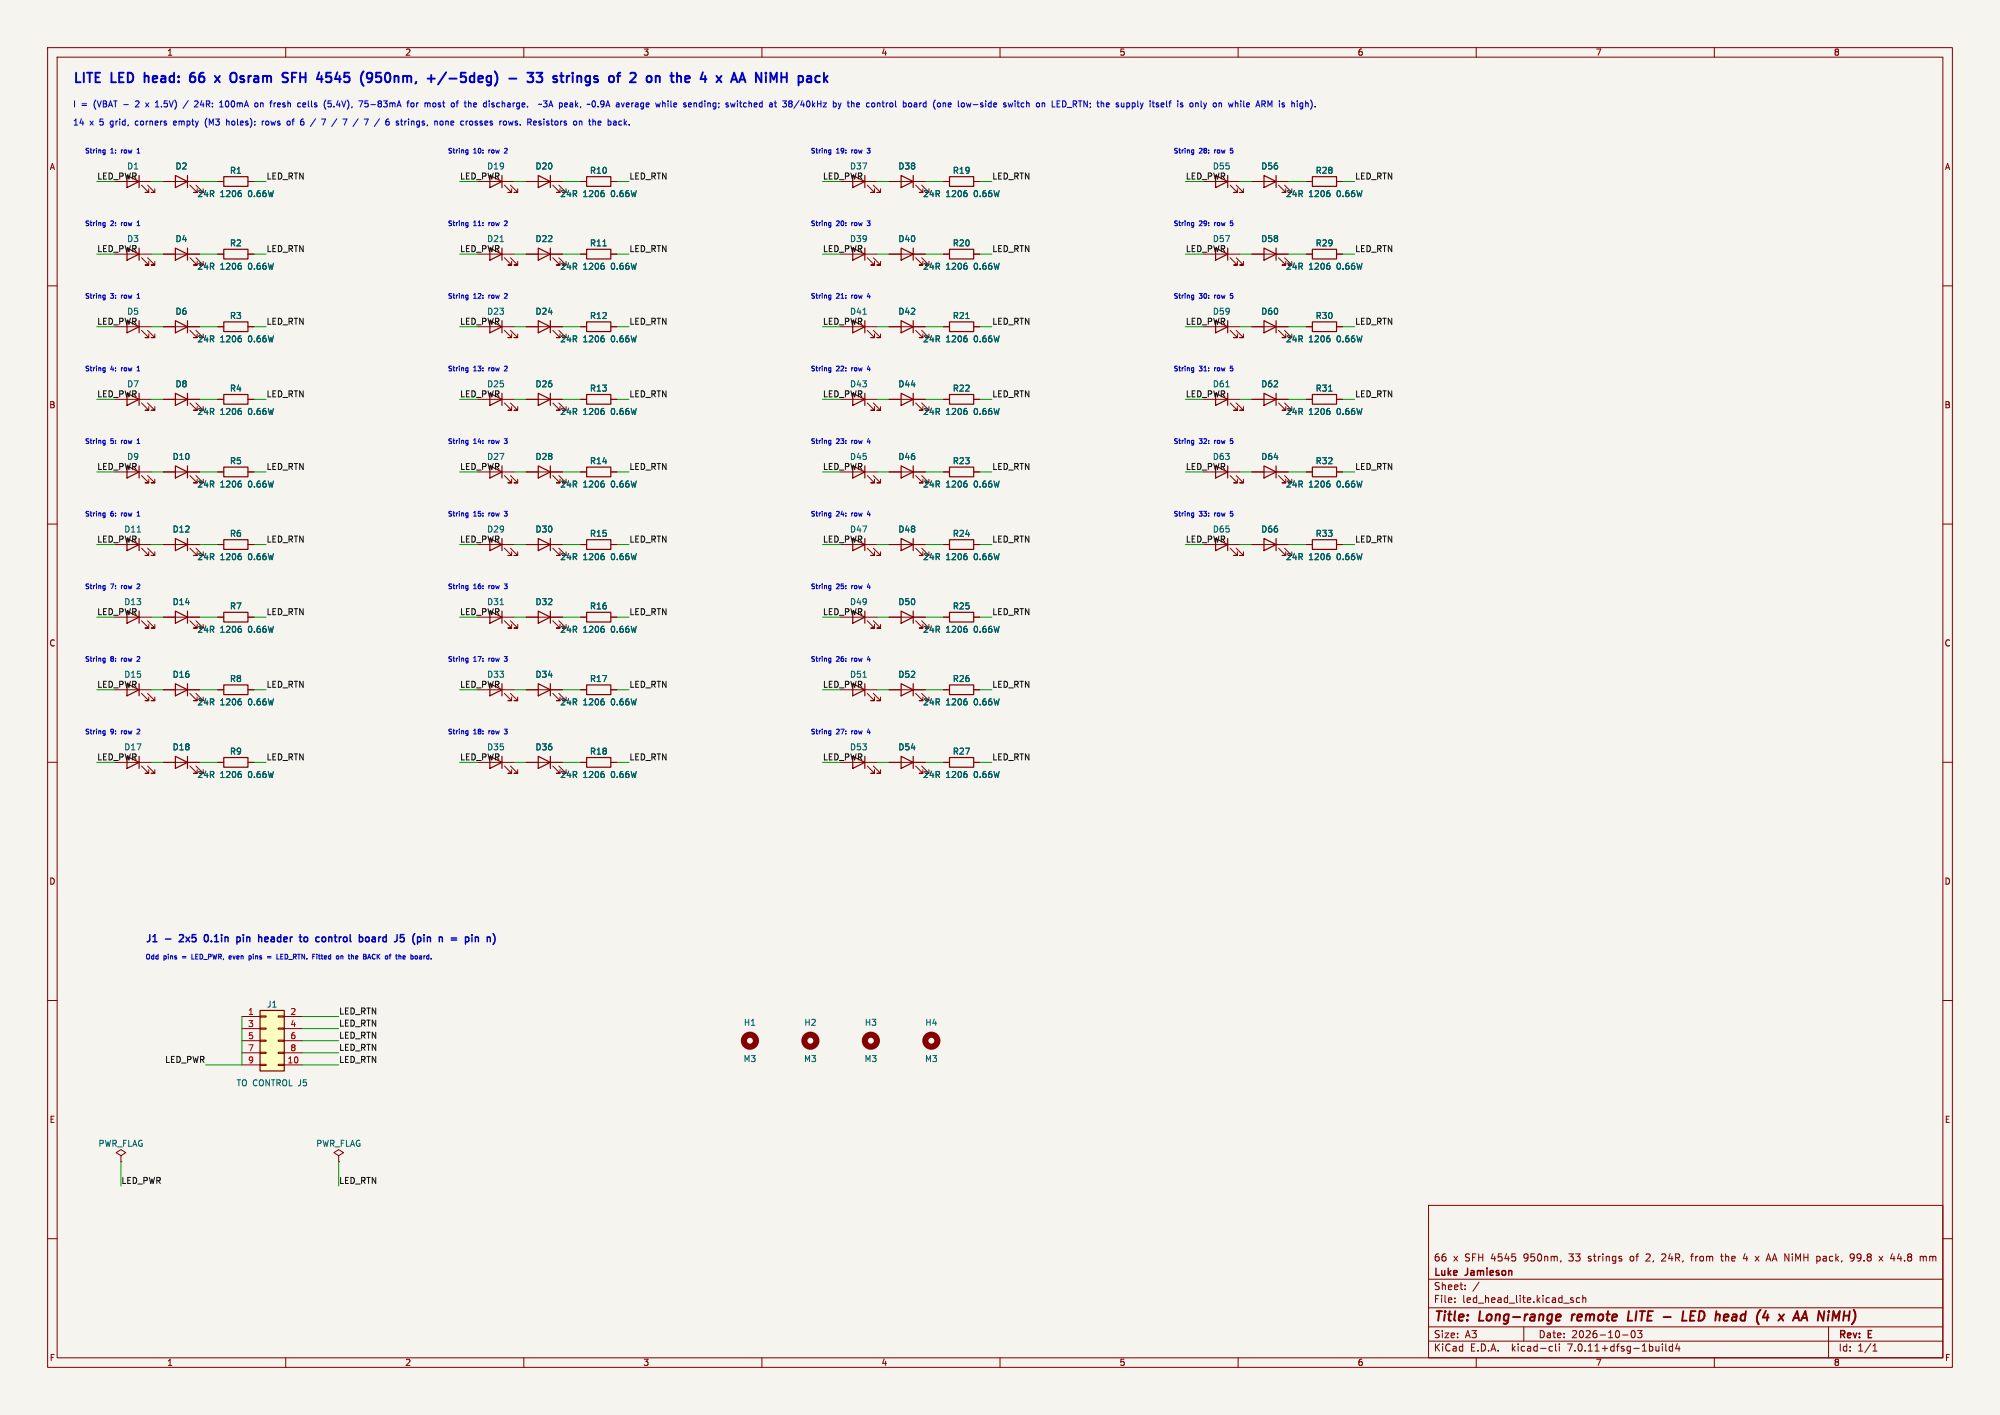
[picture p60: page 1]
