LukeRJamieson/long-range-remote/led_head_lite/led_head_lite.kicad_pcb

## KiCad design led_head_lite/led_head_lite.kicad_pcb (2026-10-17)

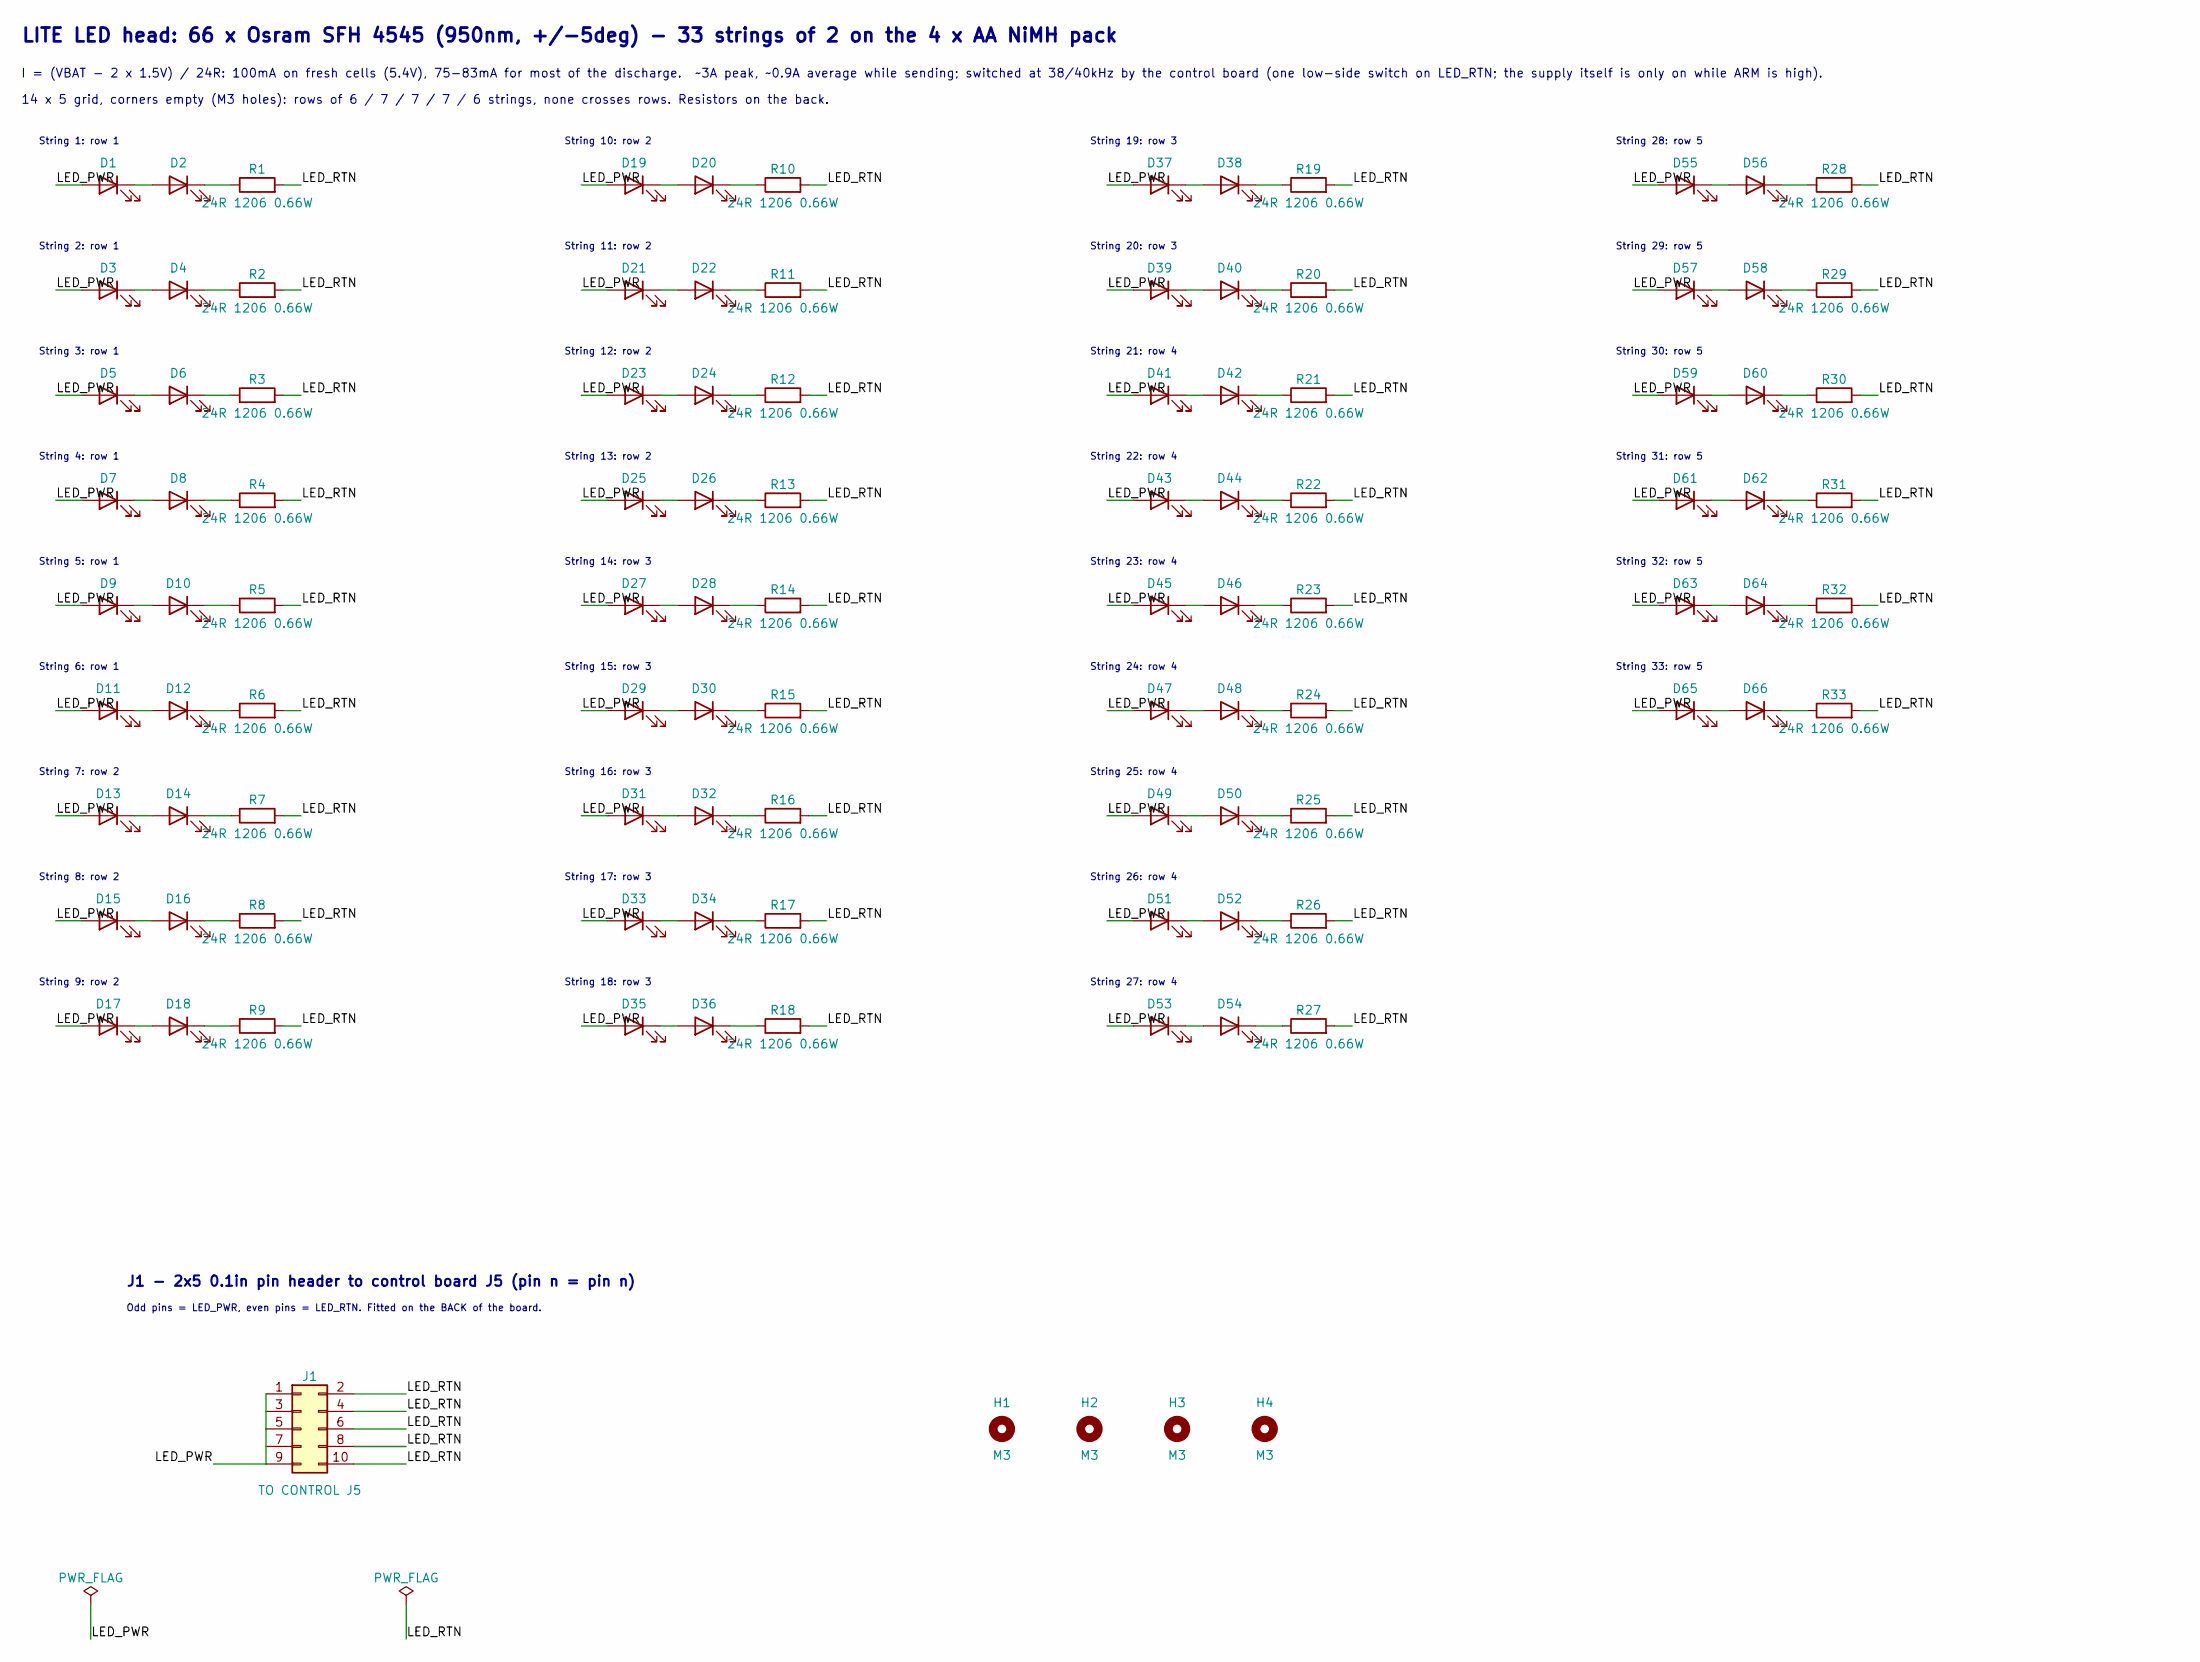
[picture p61: schematic led_head_lite.kicad_sch, Long-range remote LITE - LED head (4 x AA NiMH)]

Parts:
D1, D2, D3, D4, D5, D6, D7, D8, D9, D10, D11, D12, D13, D14, D15, D16, D17, D18, D19, D20, D21, D22, D23, D24, D25, D26, D27, D28, D29, D30, D31, D32, D33, D34, D35, D36, D37, D38, D39, D40, D41, D42, D43, D44, D45, D46, D47, D48, D49, D50, D51, D52, D53, D54, D55, D56, D57, D58, D59, D60, D61, D62, D63, D64, D65, D66: SFH 4545; LED_D5.0mm
H1, H2, H3, H4: M3; MountingHole_3.2mm_M3
J1: TO CONTROL J5; PinHeader_2x05_P2.54mm_Vertical; MPN Sullins PRPC005DAAN-RC
R1, R2, R3, R4, R5, R6, R7, R8, R9, R10, R11, R12, R13, R14, R15, R16, R17, R18, R19, R20, R21, R22, R23, R24, R25, R26, R27, R28, R29, R30, R31, R32, R33: 24R 1206 0.66W; R_1206_3216Metric_Pad1.30x1.75mm_HandSolder; MPN Panasonic ERJ-P08J240V

Connections:
/LED_PWR: D1.2 (A), D3.2 (A), D5.2 (A), D7.2 (A), D9.2 (A), D11.2 (A), D13.2 (A), D15.2 (A), D17.2 (A), D19.2 (A), D21.2 (A), D23.2 (A), D25.2 (A), D27.2 (A), D29.2 (A), D31.2 (A), D33.2 (A), D35.2 (A), D37.2 (A), D39.2 (A), D41.2 (A), D43.2 (A), D45.2 (A), D47.2 (A), D49.2 (A), D51.2 (A), D53.2 (A), D55.2 (A), D57.2 (A), D59.2 (A), D61.2 (A), D63.2 (A), D65.2 (A), J1.1, J1.3, J1.5, J1.7, J1.9
/LED_RTN: J1.2, J1.4, J1.6, J1.8, J1.10, R1.2, R2.2, R3.2, R4.2, R5.2, R6.2, R7.2, R8.2, R9.2, R10.2, R11.2, R12.2, R13.2, R14.2, R15.2, R16.2, R17.2, R18.2, R19.2, R20.2, R21.2, R22.2, R23.2, R24.2, R25.2, R26.2, R27.2, R28.2, R29.2, R30.2, R31.2, R32.2, R33.2
unnamed: D1.1 (K), D2.2 (A)
unnamed: D2.1 (K), R1.1
unnamed: D3.1 (K), D4.2 (A)
unnamed: D4.1 (K), R2.1
unnamed: D5.1 (K), D6.2 (A)
unnamed: D6.1 (K), R3.1
unnamed: D7.1 (K), D8.2 (A)
unnamed: D8.1 (K), R4.1
unnamed: D9.1 (K), D10.2 (A)
unnamed: D10.1 (K), R5.1
unnamed: D11.1 (K), D12.2 (A)
unnamed: D12.1 (K), R6.1
unnamed: D13.1 (K), D14.2 (A)
unnamed: D14.1 (K), R7.1
unnamed: D15.1 (K), D16.2 (A)
unnamed: D16.1 (K), R8.1
unnamed: D17.1 (K), D18.2 (A)
unnamed: D18.1 (K), R9.1
unnamed: D19.1 (K), D20.2 (A)
unnamed: D20.1 (K), R10.1
unnamed: D21.1 (K), D22.2 (A)
unnamed: D22.1 (K), R11.1
unnamed: D23.1 (K), D24.2 (A)
unnamed: D24.1 (K), R12.1
unnamed: D25.1 (K), D26.2 (A)
unnamed: D26.1 (K), R13.1
unnamed: D27.1 (K), D28.2 (A)
unnamed: D28.1 (K), R14.1
unnamed: D29.1 (K), D30.2 (A)
unnamed: D30.1 (K), R15.1
unnamed: D31.1 (K), D32.2 (A)
unnamed: D32.1 (K), R16.1
unnamed: D33.1 (K), D34.2 (A)
unnamed: D34.1 (K), R17.1
unnamed: D35.1 (K), D36.2 (A)
unnamed: D36.1 (K), R18.1
unnamed: D37.1 (K), D38.2 (A)
unnamed: D38.1 (K), R19.1
unnamed: D39.1 (K), D40.2 (A)
unnamed: D40.1 (K), R20.1
unnamed: D41.1 (K), D42.2 (A)
unnamed: D42.1 (K), R21.1
unnamed: D43.1 (K), D44.2 (A)
unnamed: D44.1 (K), R22.1
unnamed: D45.1 (K), D46.2 (A)
unnamed: D46.1 (K), R23.1
unnamed: D47.1 (K), D48.2 (A)
unnamed: D48.1 (K), R24.1
unnamed: D49.1 (K), D50.2 (A)
unnamed: D50.1 (K), R25.1
unnamed: D51.1 (K), D52.2 (A)
unnamed: D52.1 (K), R26.1
unnamed: D53.1 (K), D54.2 (A)
unnamed: D54.1 (K), R27.1
unnamed: D55.1 (K), D56.2 (A)
unnamed: D56.1 (K), R28.1
unnamed: D57.1 (K), D58.2 (A)
unnamed: D58.1 (K), R29.1
unnamed: D59.1 (K), D60.2 (A)
unnamed: D60.1 (K), R30.1
unnamed: D61.1 (K), D62.2 (A)
unnamed: D62.1 (K), R31.1
unnamed: D63.1 (K), D64.2 (A)
unnamed: D64.1 (K), R32.1
unnamed: D65.1 (K), D66.2 (A)
unnamed: D66.1 (K), R33.1

Notes on the sheet:
LITE LED head: 66 x Osram SFH 4545 (950nm, +/-5deg) - 33 strings of 2 on the 4 x AA NiMH pack
I = (VBAT - 2 x 1.5V) / 24R: 100mA on fresh cells (5.4V), 75-83mA for most of the discharge. ~3A peak, ~0.9A average while sending; switched at 38/40kHz by the control board (one low-side switch on LED_RTN; the supply itself is only on while ARM is high).
14 x 5 grid, corners empty (M3 holes): rows of 6 / 7 / 7 / 7 / 6 strings, none crosses rows. Resistors on the back.
String 1: row 1
String 2: row 1
String 3: row 1
String 4: row 1
String 5: row 1
String 6: row 1
String 7: row 2
String 8: row 2
String 9: row 2
String 10: row 2
String 11: row 2
String 12: row 2
String 13: row 2
String 14: row 3
String 15: row 3
String 16: row 3
String 17: row 3
String 18: row 3
String 19: row 3
String 20: row 3
String 21: row 4
String 22: row 4
String 23: row 4
String 24: row 4
String 25: row 4
String 26: row 4
String 27: row 4
String 28: row 5
String 29: row 5
String 30: row 5
String 31: row 5
String 32: row 5
String 33: row 5
J1 - 2x5 0.1in pin header to control board J5 (pin n = pin n)
Odd pins = LED_PWR, even pins = LED_RTN. Fitted on the BACK of the board.

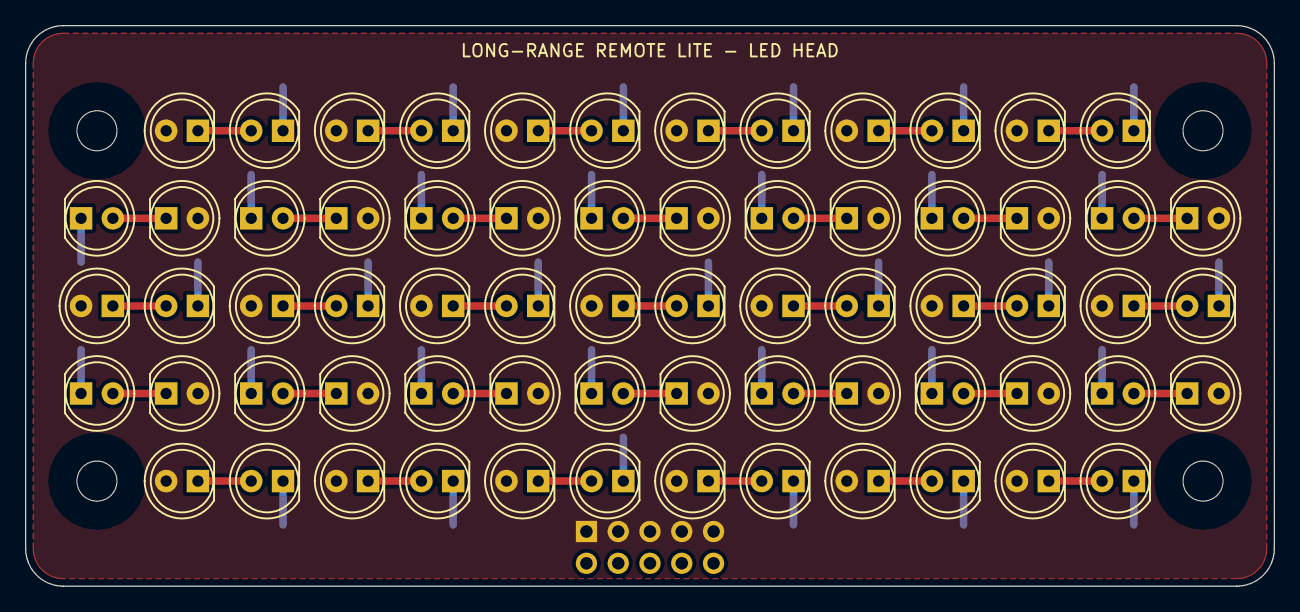
[picture p62: board led_head_lite.kicad_pcb from above]

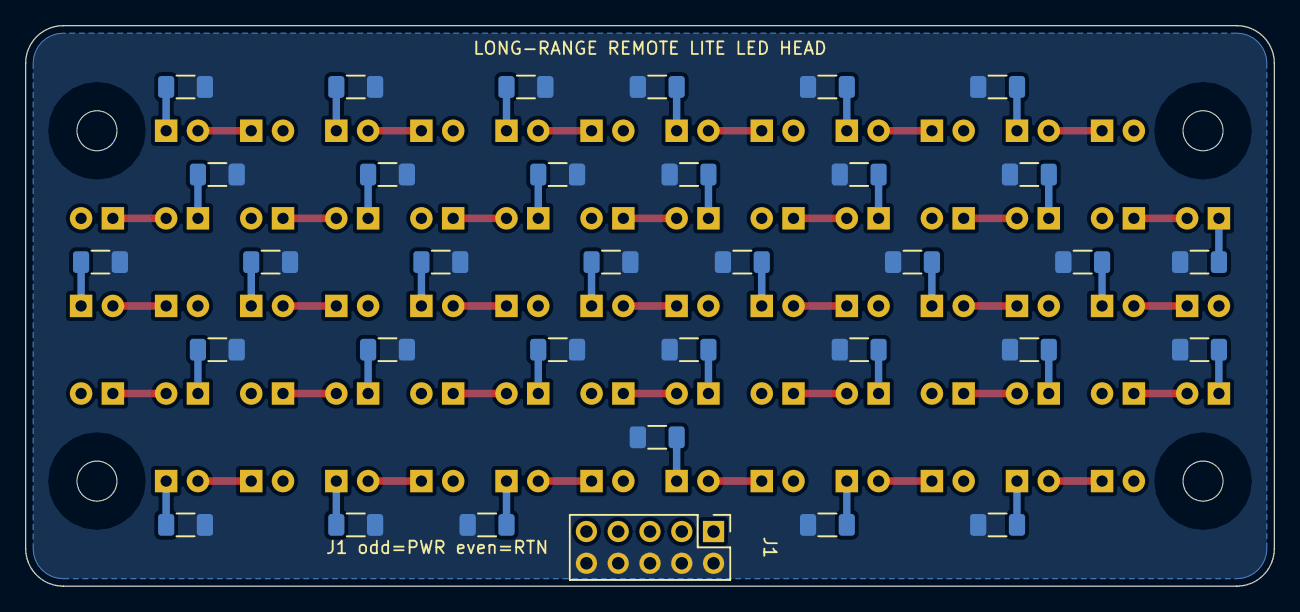
[picture p63: board led_head_lite.kicad_pcb from below]

Board: 2 copper layers, 99.8 x 44.8 mm, 104 parts (34 on the bottom side), 68 nets.
