LukeRJamieson/long-range-remote/control_lite/control_lite.kicad_pcb

## KiCad design control_lite/control_lite.kicad_pcb (2026-10-17)

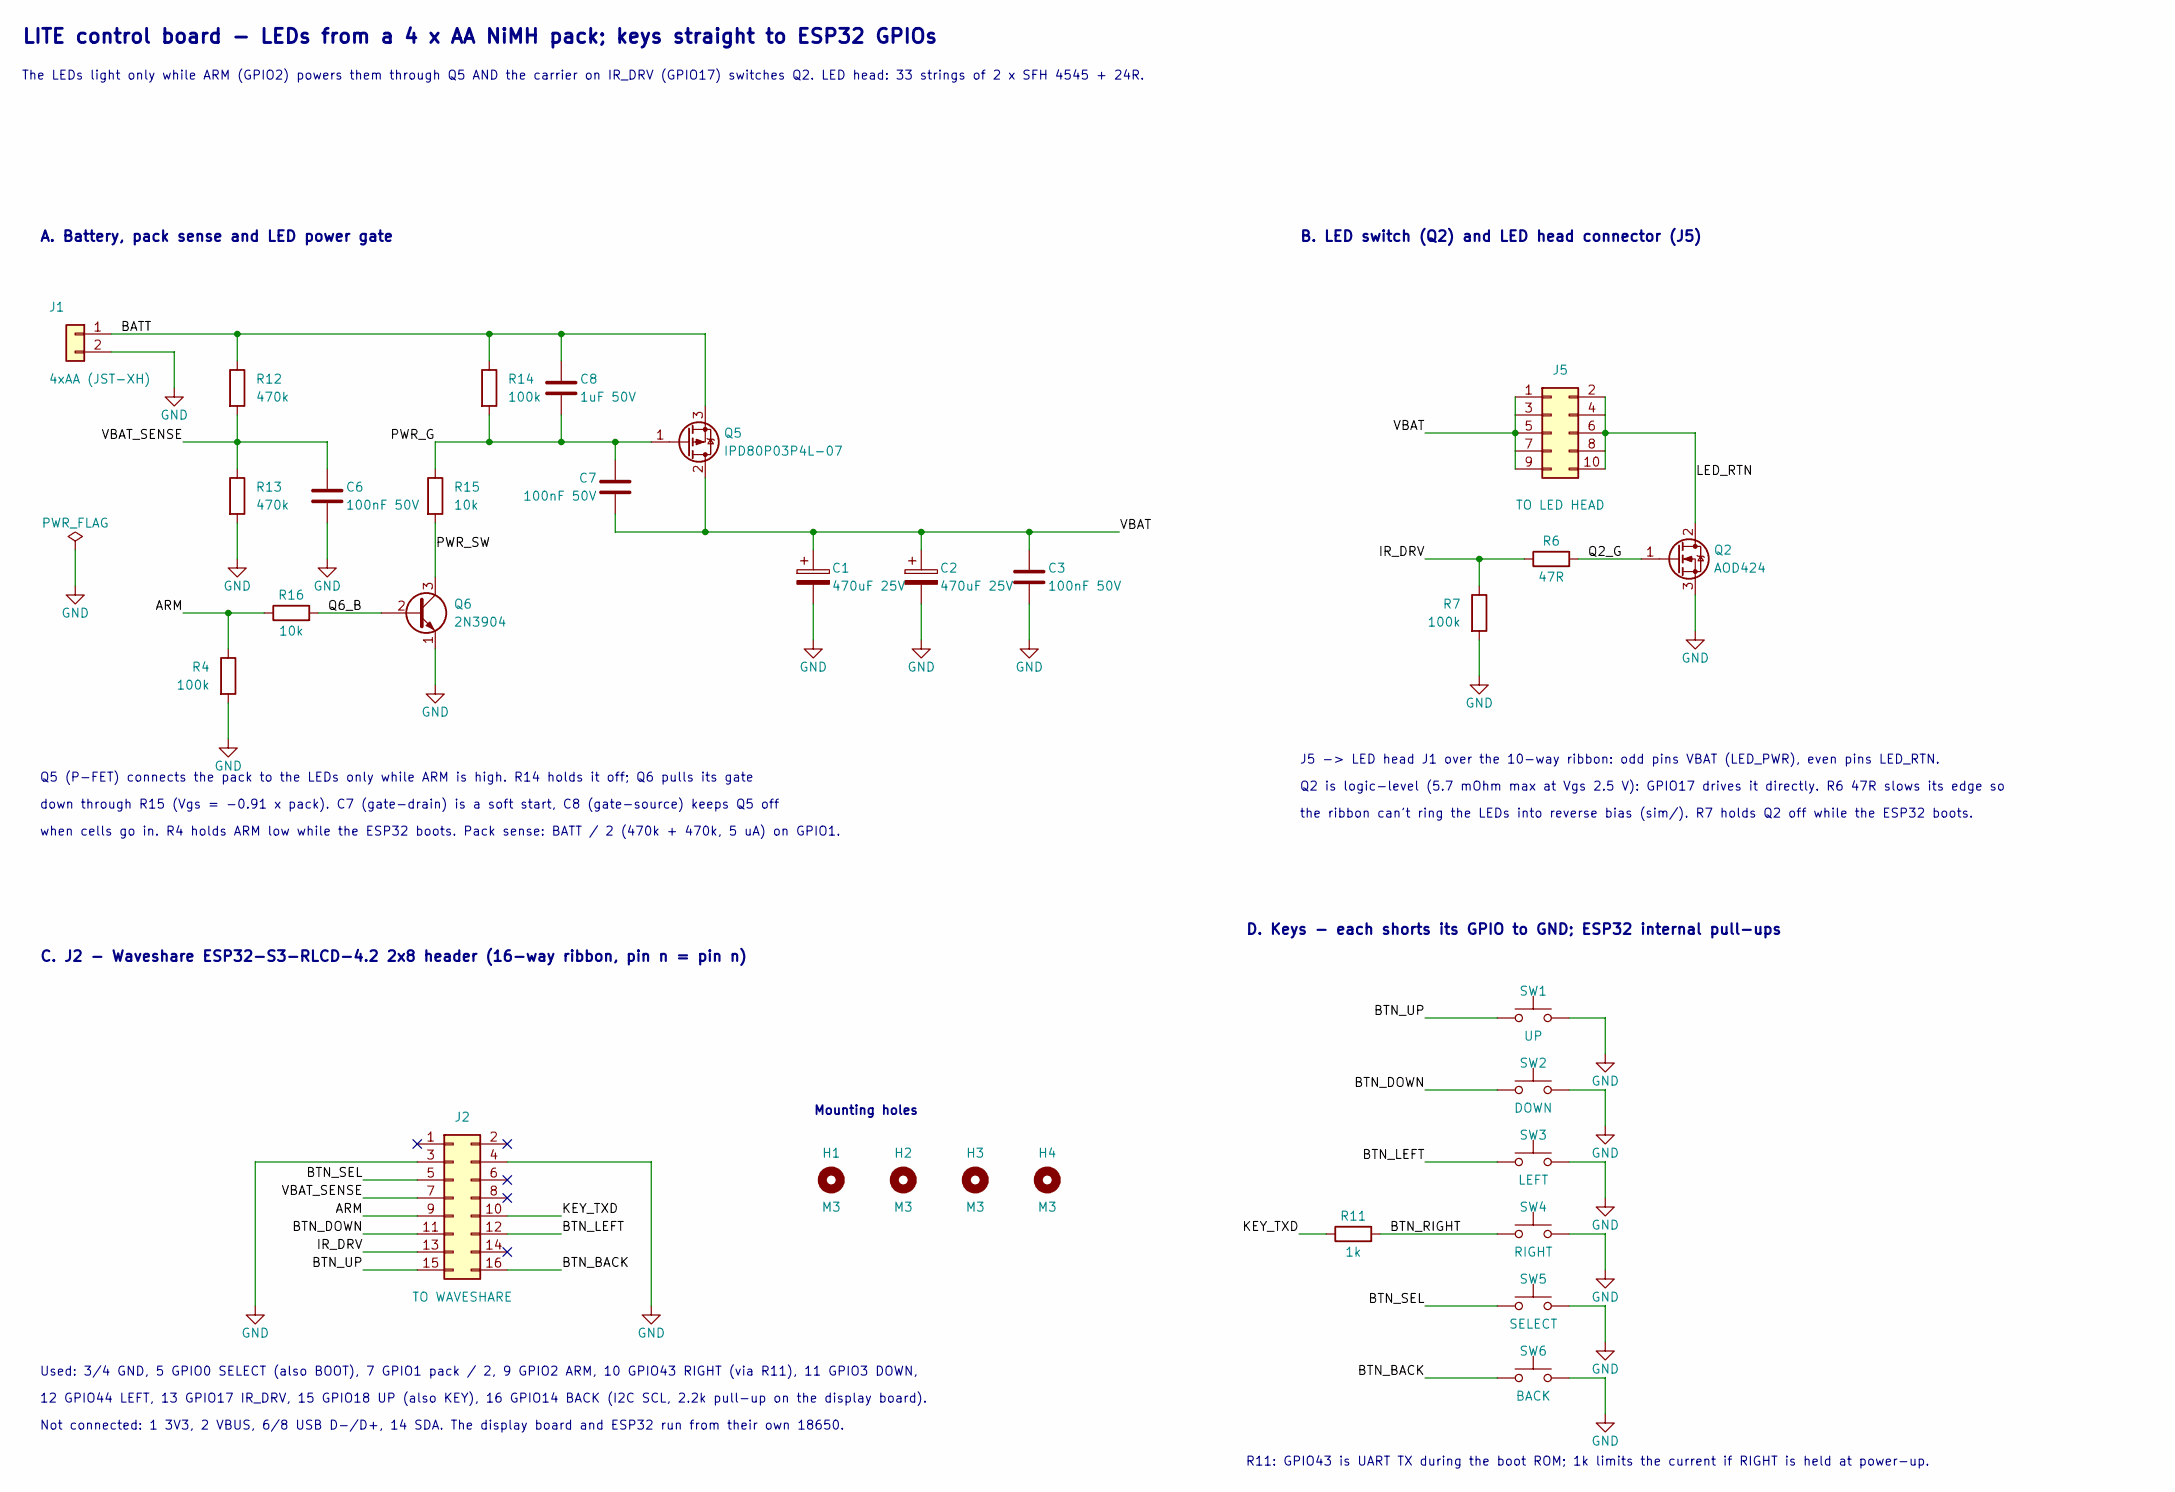
[picture p64: schematic control_lite.kicad_sch, Long-range remote LITE - control board (4 x AA NiMH)]

Parts:
C1, C2: 470uF 25V; CP_Radial_D10.0mm_P5.00mm; MPN Panasonic EEU-FR1E471
C3, C6, C7: 100nF 50V; C_Rect_L4.0mm_W2.5mm_P2.50mm; MPN TDK FG18X7R1H104KNT06
C8: 1uF 50V; C_Disc_D5.1mm_W3.2mm_P5.00mm; MPN TDK FG24X7R1H105KRT06
H1, H2, H3, H4: M3; MountingHole_3.2mm_M3
J1: 4xAA (JST-XH); JST_XH_B2B-XH-A_1x02_P2.50mm_Vertical; MPN JST B2B-XH-A
J2: TO WAVESHARE; IDC-Header_2x08_P2.54mm_Vertical; MPN Wurth 61201621621
J5: TO LED HEAD; IDC-Header_2x05_P2.54mm_Vertical; MPN Wurth 61201021621
Q2: AOD424; TO-252-2; MPN Alpha & Omega AOD424
Q5: IPD80P03P4L-07; TO-252-2; MPN Infineon IPD80P03P4L07ATMA2
Q6: 2N3904; TO-92_Inline_Wide; MPN onsemi 2N3904BU
R4, R7, R14: 100k; R_Axial_DIN0207_L6.3mm_D2.5mm_P7.62mm_Horizontal; MPN Yageo MFR-25FBF52-100K
R6: 47R; R_Axial_DIN0207_L6.3mm_D2.5mm_P7.62mm_Horizontal; MPN Yageo MFR-25FBF52-47R
R11: 1k; R_Axial_DIN0207_L6.3mm_D2.5mm_P7.62mm_Horizontal; MPN Yageo MFR-25FBF52-1K
R12, R13: 470k; R_Axial_DIN0207_L6.3mm_D2.5mm_P7.62mm_Horizontal; MPN Yageo MFR-25FBF52-470K
R15, R16: 10k; R_Axial_DIN0207_L6.3mm_D2.5mm_P7.62mm_Horizontal; MPN Yageo MFR-25FBF52-10K
SW1: UP; SW_PUSH_6mm; MPN Omron B3F-1000 (6mm)
SW2: DOWN; SW_PUSH_6mm; MPN Omron B3F-1000 (6mm)
SW3: LEFT; SW_PUSH_6mm; MPN Omron B3F-1000 (6mm)
SW4: RIGHT; SW_PUSH_6mm; MPN Omron B3F-1000 (6mm)
SW5: SELECT; SW_PUSH_6mm; MPN Omron B3F-1000 (6mm)
SW6: BACK; SW_PUSH_6mm; MPN Omron B3F-1000 (6mm)

Connections:
/ARM: J2.9, R4.1, R16.1
/BATT: C8.1, J1.1, Q5.3 (S), R12.1, R14.1
/BTN_BACK: J2.16, SW6.1
/BTN_DOWN: J2.11, SW2.1
/BTN_LEFT: J2.12, SW3.1
/BTN_RIGHT: R11.2, SW4.1
/BTN_SEL: J2.5, SW5.1
/BTN_UP: J2.15, SW1.1
/IR_DRV: J2.13, R6.1, R7.1
/KEY_TXD: J2.10, R11.1
/LED_RTN: J5.2, J5.4, J5.6, J5.8, J5.10, Q2.2 (D)
/PWR_G: C7.1, C8.2, Q5.1 (G), R14.2, R15.1
/PWR_SW: Q6.3 (C), R15.2
/Q2_G: Q2.1 (G), R6.2
/Q6_B: Q6.2 (B), R16.2
/VBAT: C1.1, C2.1, C3.1, C7.2, J5.1, J5.3, J5.5, J5.7, J5.9, Q5.2 (D)
/VBAT_SENSE: C6.1, J2.7, R12.2, R13.1
GND: C1.2, C2.2, C3.2, C6.2, J1.2, J2.3, J2.4, Q2.3 (S), Q6.1 (E), R4.2, R7.2, R13.2, SW1.2, SW2.2, SW3.2, SW4.2, SW5.2, SW6.2

Notes on the sheet:
LITE control board - LEDs from a 4 x AA NiMH pack; keys straight to ESP32 GPIOs
The LEDs light only while ARM (GPIO2) powers them through Q5 AND the carrier on IR_DRV (GPIO17) switches Q2. LED head: 33 strings of 2 x SFH 4545 + 24R.
A. Battery, pack sense and LED power gate
Q5 (P-FET) connects the pack to the LEDs only while ARM is high. R14 holds it off; Q6 pulls its gate
down through R15 (Vgs = -0.91 x pack). C7 (gate-drain) is a soft start, C8 (gate-source) keeps Q5 off
when cells go in. R4 holds ARM low while the ESP32 boots. Pack sense: BATT / 2 (470k + 470k, 5 uA) on GPIO1.
B. LED switch (Q2) and LED head connector (J5)
J5 -> LED head J1 over the 10-way ribbon: odd pins VBAT (LED_PWR), even pins LED_RTN.
Q2 is logic-level (5.7 mOhm max at Vgs 2.5 V): GPIO17 drives it directly. R6 47R slows its edge so
the ribbon can't ring the LEDs into reverse bias (sim/). R7 holds Q2 off while the ESP32 boots.
C. J2 - Waveshare ESP32-S3-RLCD-4.2 2x8 header (16-way ribbon, pin n = pin n)
Used: 3/4 GND, 5 GPIO0 SELECT (also BOOT), 7 GPIO1 pack / 2, 9 GPIO2 ARM, 10 GPIO43 RIGHT (via R11), 11 GPIO3 DOWN,
12 GPIO44 LEFT, 13 GPIO17 IR_DRV, 15 GPIO18 UP (also KEY), 16 GPIO14 BACK (I2C SCL, 2.2k pull-up on the display board).
Not connected: 1 3V3, 2 VBUS, 6/8 USB D-/D+, 14 SDA. The display board and ESP32 run from their own 18650.
Mounting holes
D. Keys - each shorts its GPIO to GND; ESP32 internal pull-ups
R11: GPIO43 is UART TX during the boot ROM; 1k limits the current if RIGHT is held at power-up.

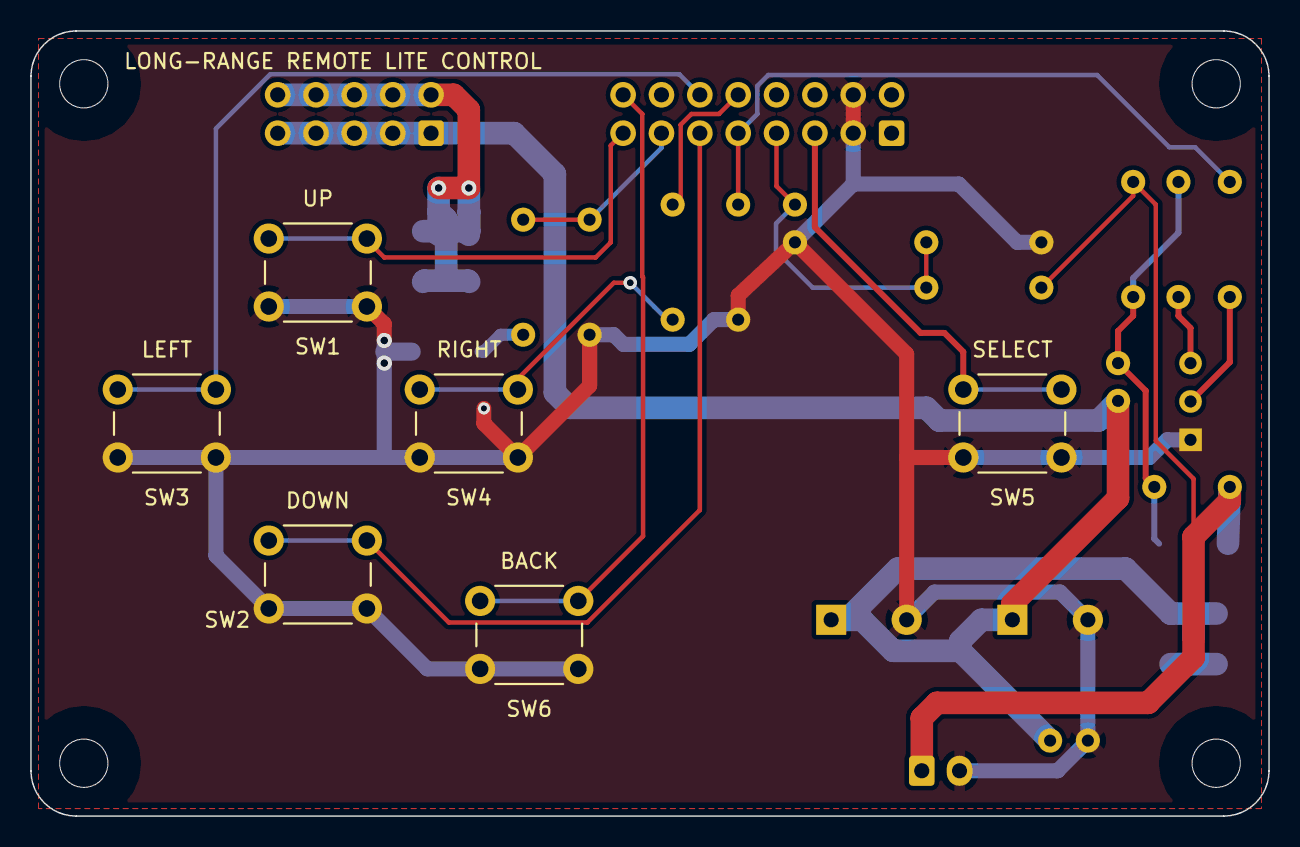
[picture p65: board control_lite.kicad_pcb from above]

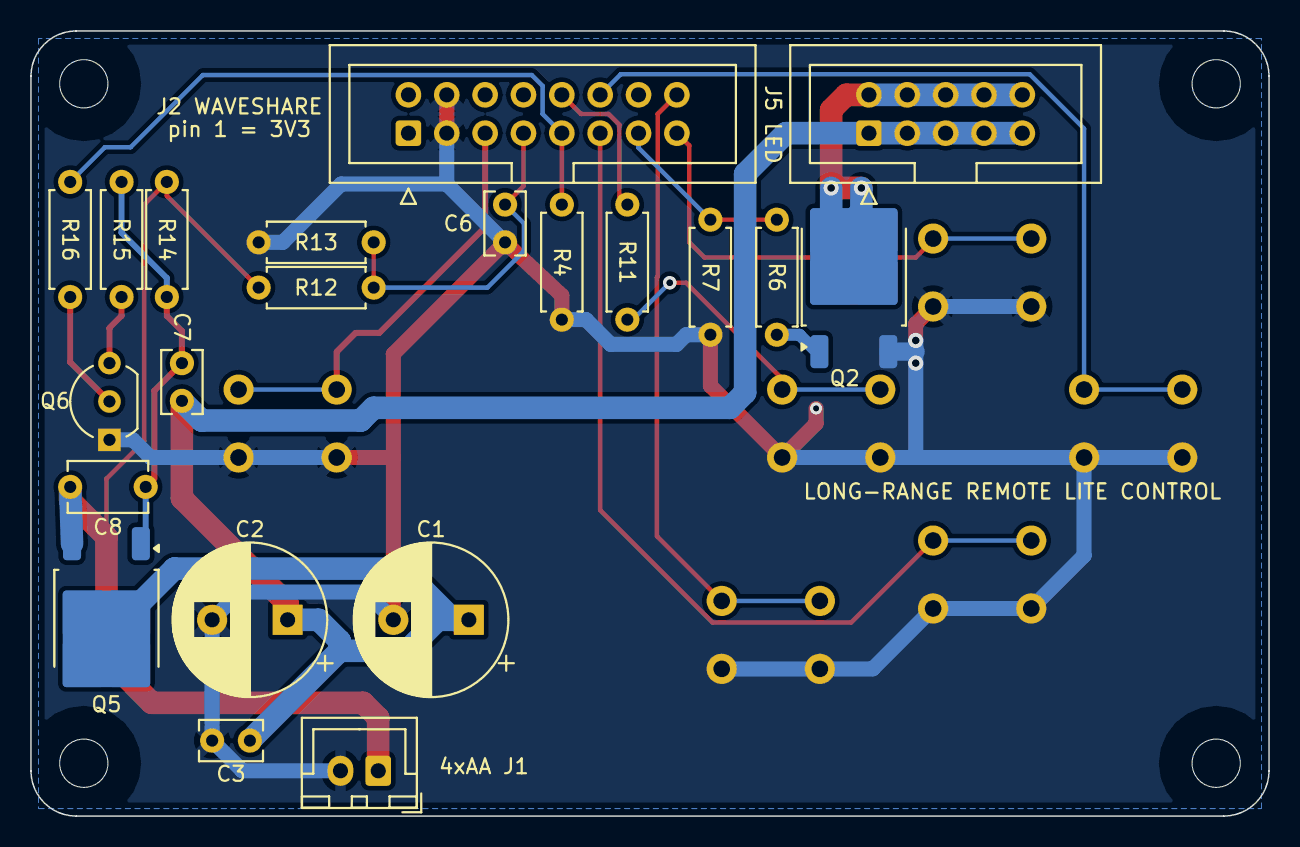
[picture p66: board control_lite.kicad_pcb from below]

Board: 2 copper layers, 82.0 x 52.0 mm, 31 parts (21 on the bottom side), 18 nets.
