LukeRJamieson/long-range-remote/firmware/LongRangeRemote/settings.h

// settings.h - persistent settings: favourite devices, active device, LED power, sound (NVS), and the home
// Wi-Fi network (/wifi.txt on the SD card).
// Favourites are stored by "Brand|Profile" name so they survive database regeneration.
#pragma once
#include <Arduino.h>
#include "config.h"

namespace settings {

void begin();

// Favourites (profile indices into irdb). The active device is always a favourite.
int  favCount();
int  fav(int i);
bool isFav(int profile);
bool addFav(int profile);          // false if the list is full
void removeFav(int profile);       // if it was the active device, the next one becomes active
void clearFavs();                  // remove every saved device (no active device afterwards)

int  active();                     // active profile index, -1 if none
void setActive(int profile);       // also adds it to favourites
// For a remote that is on the card but not loaded yet (just saved): make it the active device and
// a favourite as of the next start-up.
void setActiveByName(const char *brand, const char *remote);

int  ledPower();                   // LED power level, 0 = full (saved; applied to irtx at start-up)
void setLedPower(int level);       // clamps, saves and applies it

int  soundVolume();                // key-sound volume 0..SOUND_VOLUME_MAX (saved; applied to sound)
void setSoundVolume(int level);    // clamps, saves and applies it
bool soundMuted();
void setSoundMuted(bool m);        // saves and applies it; the volume is kept for unmuting

// Code search Auto: time between codes in ms, one of SCAN_AUTO_STEPS_MS (saved). Used by the screen
// and the web page, so both run at the same speed.
int  scanAutoMs();
void setScanAutoMs(int ms);        // snaps to the nearest step and saves it
int  scanAutoStep(int ms, int dir);// the step next to ms: dir +1 slower, -1 faster (stops at the ends), 0 nearest
void formatSeconds(int ms, char *out, size_t n);   // 750 -> "0.75 s", 1000 -> "1 s"

// Home Wi-Fi network. Read from /wifi.txt on the SD card at start-up (format: wifi_file.h). If the
// card has no wifi.txt, the defaults in config.h (HOME_WIFI_SSID / HOME_WIFI_PASSWORD) are used and
// written to a new wifi.txt, so the card always shows what the remote uses.
String wifiSsid();
String wifiPass();
const char *wifiSource();          // where the network is kept, one line for the screens
bool wifiSaved();                  // false: the current network is not on the card (no card / write failed)

// Change the home network (the Wi-Fi menu). It is checked first (wififile::check): if it can't be
// used, false + why in msg, and nothing changes. Otherwise it is used at once and saved to
// /wifi.txt, and msg says whether the save worked (without a card, or if the write fails, it
// lasts until the remote restarts). The caller then calls wifimgr::reconnect().
bool setWifi(const String &ssid, const String &pass, char *msg, size_t msg_len);

// Write the current home network to /wifi.txt again (after the card was formatted). false + err if
// the write failed.
bool rewriteWifiFile(char *err, size_t err_len);

}  // namespace settings
