LukeRJamieson/long-range-remote/(commit log)

2026-10-17 Long-range universal IR remote (Lite, 4 x AA)
    Hardware, firmware and housing for a hand-held universal IR remote:
    - LED head: 66 x SFH 4545 on 4 x AA NiMH, and the control board (keys, power
    gate, LED switch), as KiCad projects with JLCPCB gerbers, BOMs and PDFs
    - Firmware for the Waveshare ESP32-S3-RLCD-4.2: IR codes on the SD card,
    on-device UI, phone web remote, home Wi-Fi from wifi.txt, key sounds,
    idle sleep
    - 3D-printable housing (CadQuery source, STEP, STL)
    - User guide (docs/), generators and checks (tools/), simulations (sim/)
    Claude-Session: https://claude.ai/code/session_013FR9VaNd2Z6uCQRPLBLU1A
    [bezel.step, bezel.stl, body.step, body.stl, body_bay_support_enforcer.stl, control_lite.kicad_pcb, control_lite.kicad_sch, door.step]
2026-10-18 Web page: format the SD card
    Settings > Format the SD card erases the card and formats it FAT32 (32 KB
    clusters). It also works on a card that didn't mount at start-up. By default
    the code database in memory and wifi.txt are written back afterwards, so no
    upload is needed; your own .ir files are erased.
    - sdstore::format(): esp_vfs_fat_sdcard_format_cfg, mounting with
    format-if-needed first when the card wasn't mounted
    - settings::rewriteWifiFile(); POST /api/format?confirm=FORMAT&keep=1|0
    - README and user guide updated
    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
    [sd_store.cpp, sd_store.h, settings.cpp, settings.h, web.cpp]
2026-10-18 Housing: stronger display snap hooks, crush ribs
    The display popped out of the lid too easily. Its four snap hooks stood
    0.6 mm out from the sleeve wall, less the 0.3 mm sleeve clearance: a
    0.3 mm overlap with the back plate, and none if the display sat to one
    side.
    - Hooks stand 1.5 mm out (1.2 mm overlap), 12 mm wide, at x +-27, on
    13 mm arms (under 2 % strain on insertion), with a 1.7 mm lead-in ramp
    - Two 0.15 mm crush ribs per long wall (x +-40) centre the display
    - Checked against Waveshare's 3D model: no clashes, all four hooks land
    fully on the back case; no clashes with the 241 keep-out volumes
    - README and guide: firm push to fit it; how to take it out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
    [bezel.step, body.step, door.step, keycap_back.step, keycap_dpad.step, keycap_select.step, lid.step, lid.stl]
2026-10-18 Housing: open the display-button slot to the lid's front edge
    The 38 x 8 mm slot in front of the display left a 3 mm strip of lid
    between it and the front edge. The slot now runs right out through the
    edge (38 x 11 mm notch, open to the tray's front wall), so a fingertip
    can reach the display's KEY / PWR / BOOT buttons as well as a thin tool.
    Still clear of the front snap hooks' slits and of the tray wall; the
    housing keep-out check passes. README and guide updated.
    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
    [bezel.step, body.step, door.step, keycap_back.step, keycap_dpad.step, keycap_select.step, lid.step, lid.stl]
2026-10-18 Housing: PWR lever, flicked from the face of the lid
    A straight lever on a 1.75 mm filament pin in two cheeks under the lid.
    Its tab stands 3 mm proud of the lid in front of the screen; flicking it
    forwards swings a nub on its lower end onto the display's PWR plunger
    (side tact switch, pressed rearwards). The PWR switch's own spring
    returns it, and the lid slot stops the tab at 11 deg (nub 0.75 mm), so
    it can't over-press the switch.
    - Plunger position from Waveshare's model: 3.0 x 1.0 mm, 4.15-5.15 mm
    below the glass, tip 0.19 mm inside the display edge; the nub sits
    below the board edge (4.5-5.1) and 0.3 mm off the plunger (NUB_GAP)
    - tools/waveshare_fit.py swings the lever to its sto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
    [bezel.step, body.step, door.step, keycap_back.step, keycap_dpad.step, keycap_select.step, lid.step, lid.stl]
2026-10-19 Housing: snap-hook catches 0.5 mm further from the lid
    The display still wouldn't clip in: with the catches' top face exactly at
    the back plate's depth in Waveshare's model (13.5 mm below the glass), a
    real display didn't get past them. New HOOK_SLACK (0.5 mm) moves the
    catches down; the arms, ramps and slits move with them. Lid 19.0 mm tall.
    Waveshare model fit and housing keep-out checks still pass.
    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
    [bezel.step, body.step, door.step, keycap_back.step, keycap_dpad.step, keycap_select.step, lid.step, lid.stl]
2026-10-19 Housing: hooks another 0.2 mm lower; looser PWR lever pin holes
    - HOOK_SLACK 0.5 -> 0.7: the display still wouldn't clip in
    - Pin holes 1.8 / 2.0 printed far too tight to get the filament through:
    now 2.2 in the cheeks and 2.4 in the lever, both free on 1.75 mm
    filament; a melted head on the pin plus a dab of glue keeps it in.
    Lever 0.3 mm thicker (5.0) to keep 0.8 mm walls round its hole; cheeks
    0.3 mm deeper (3.3)
    - Waveshare model fit, lever stop and housing keep-out checks still pass
    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
    [bezel.step, body.step, door.step, keycap_back.step, keycap_dpad.step, keycap_select.step, lid.step, lid.stl]
2026-10-19 Housing: V2 display board (0.6 mm thicker)
    Waveshare ship a V2 ESP32-S3-RLCD-4.2 from 10 Oct 2026: a thicker acrylic
    spacer puts the board and everything on it 0.6 mm further from the screen
    (LCD to board 3.75 -> 4.35 mm, overall 13.5 -> 14.1 mm). Their 3D model,
    which the housing was fitted to, is V1. That is why the display wouldn't
    clip in until the catches were 0.7 mm lower, and the PWR lever's nub sat
    at the board's bottom corner instead of on the plunger.
    - housing_base: DISP_V2 (default True) adds DISP_DROP = 0.6 mm to every
    depth taken from the model: DISP_T, USB-C / TF openings, board face,
    18650 cell and holder, header face and ribbon-socket stack. HOOK_SLACK
    back to 0.1 (ca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
    [bezel.step, body.step, body.stl, door.step, keycap_back.step, keycap_dpad.step, keycap_select.step, lid.step]
2026-10-19 Housing: tougher snap hooks; display thickness as measured (14.35 mm)
    - One hook broke off. The lid prints top-down, so the arms bend across
    their layer lines, and the slits' square ends put the stress right at
    the arm's root. Now: arms 15 mm long (insertion strain ~1.4 %, was
    ~1.9 %) and 15 mm wide (was 12), at x +-28; slits with fully rounded
    ends; a 0.25 mm chamfer between the catch and the arm
    - The user's V2 board measures 14.35 mm overall (Waveshare say 14.1) and
    4.35 mm from the glass to the board's back face (as Waveshare say).
    DISP_T is the measured 14.35; the catches sit 0.15 mm beyond it, at
    14.5 mm below the glass. The board-mounted parts keep the 0.6 mm V2
    offset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
    [bezel.step, body.step, door.step, keycap_back.step, keycap_dpad.step, keycap_select.step, lid.step, lid.stl]
2026-10-19 Housing: chamfer the sleeve-to-lid joint behind the snap hooks
    A hook snapped off at the lid surface, not at the catch: the long walls'
    joint with the lid is a sharp inside corner, and with the lid printed
    top-down it bends across the layer lines. Also c4e6f2c had moved the
    slits to 1.5 mm from the lid, putting the arms' root right at that joint.
    - 2 mm 45 deg chamfer along the outside of both long walls' joint with
    the lid, x 6.5..39.5 each side (clear of the lid-screw columns and of
    the PWR lever and its cheeks); the display side has no room for one
    - Slits stop 3.5 mm below the lid (arms 13 mm), so they flex below it
    - Catches 1.3 mm (1.0 mm overlap) to keep insertion strain ~1.6 %
    -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
    [bezel.step, body.step, door.step, keycap_back.step, keycap_dpad.step, keycap_select.step, lid.step, lid.stl]
2026-10-19 Sound: no more silent first key press
    The NS4150B amplifier takes ~30 ms to start once PA_CTRL goes high (NS4150
    datasheet: start-up time 30 ms). The sound task switched it on, queued
    24 ms of silence and then the 12 ms click, so whenever the amplifier had
    been off (3 s after the last sound - e.g. the first key press after the
    start-up chime) the click went out before the amplifier was up, and how
    much of it was lost depended on where the I2S DMA was.
    - A sound now waits until the amplifier has been on SOUND_AMP_START_MS
    (45 ms) and the codec set up SOUND_CODEC_SETTLE_MS (150 ms) before it
    plays; I2S keeps sending silence meanwhile, so nothing pops
    - The amplifier stays on SOUND_AMP_HOL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
2026-10-23 Housing: clear the PWR lever pin's path; control-board bosses 1 mm longer
    - The sleeve chamfer on the front wall started at x 6.5, 1 mm outside the
    lever's cheeks and right across the pin's line, so the pin couldn't go
    in. The front chamfer now runs only behind the hooks (x 19..39.5), giving
    a 13.45 mm clear run beside each cheek (checked: no material on the pin
    line or in its hole); the rear wall keeps 6.5..39.5
    - Pin 9.5 mm (was 10.7): 1.4 mm into each cheek, ~4 mm shorter than the
    clear run, so it can be lined up and pushed in with tweezers
    - Bosses: board 9.7 mm below the lid (was 8.7: every key sat pressed on
    the first build). Key caps unchanged (CAP_DESIGN_GAP 8.7), so they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
    [bezel.step, body.step, door.step, keycap_back.step, keycap_dpad.step, keycap_select.step, lid.step, lid.stl]
2026-10-23 Housing: PWR lever nub 1 mm longer, relieved so it can't hold PWR down
    On the real board the nub didn't quite reach PWR at the lever's stop
    (the loose pin holes take up some travel too). The nub now juts out
    NUB_EXTRA = 1.0 mm further than Waveshare's model says it needs.
    So that a longer nub can never hold PWR pressed at rest (a long press
    turns the screen off), the lever's rear face is relieved 1 mm (45 deg
    ramp) where it passes through the lid: it can swing back ~1.1 mm at the
    nub without touching the lid, and PWR's own spring pushes it off.
    Lever only; the lid is unchanged. The model checks use the lever as
    modelled (extra = 0): no clashes, it meets the PWR plunger only.
    Co-Authored-B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
    [bezel.step, body.step, door.step, keycap_back.step, keycap_dpad.step, keycap_select.step, lid.step, long_range_remote_lite_housing_assembly.step]
2026-10-23 Housing previews: re-render with current lid, add PWR lever to render script
    render_lite.py predated the PWR lever (KeyError on pwr_lever); it now
    colours it, moves it with the lid in the exploded view and shows it on
    the print-layout bed.
    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
2026-11-08 Wi-Fi: fix repeated AUTH_EXPIRE (reason 2) on WPA2/WPA3 routers
    The core zeroes the station config, leaving sae_pwe_h2e unspecified, so the
    ESP32 offers only hunt-and-peck SAE. Routers in WPA2/WPA3 mixed mode that
    answer only hash-to-element SAE never reply to the auth frame and the attempt
    ends in AUTH_EXPIRE. Connect with WPA3_SAE_PWE_BOTH.
    Also back off 5/10/15/20 s after consecutive AUTH_EXPIREs and let the driver
    pick the access point from the second one, for routers that ignore a station
    retrying too quickly. Simulator scenarios 15 and 16 cover both (they fail on
    the old code).
    Claude-Session: https://claude.ai/code/session_013F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
    [wifi_mgr.cpp]
2026-11-08 Wi-Fi: recover from the router's stale session after a power cycle; stay awake on USB
    The PWR latch cuts power without a deauth, so on WPA2/WPA3 (PMF) networks the
    router keeps the old session and ignores the remote's address for minutes
    (AUTH_EXPIRE until it times out - seen as a 2-3 minute delay after power-up).
    From the 2nd consecutive AUTH_EXPIRE the station alternates between its
    factory MAC and the same address with the locally-administered bit set, which
    the router answers at once. Simulator scenarios 17-18 (old code: 13
    AUTH_EXPIREs; new: connected in ~29 s).
    Idle sleep is skipped while a USB host is attached (usb_serial_jtag_is_connected):
    light sleep stopped the USB port, so uploa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
    [config.h, wifi_mgr.cpp]
2026-11-08 Wi-Fi: fix the attempt watchdog firing instantly (unsigned time wrap)
    loop() reads millis() once, but connectTo() stamps g_attempt_started after the
    driver calls, a few ms later. now - g_attempt_started then wrapped to ~49 days
    and the 45 s watchdog killed every attempt in the same millisecond (board log,
    8 Nov). The extra esp_wifi_* calls in the H2E fix made this happen every time.
    All elapsed-time checks are now signed.
    The simulator's clock now advances during begin()/esp_wifi_connect(), which
    reproduces the failure (25 failed checks before, all 39 pass after).
    Claude-Session: https://claude.ai/code/session_013FR9VaNd2Z6uCQRPLBLU1A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
    [wifi_mgr.cpp]
2026-11-11 Web page: stay reachable on the home network (standby before sleep)
    After 90 s idle the remote switched Wi-Fi off and slept, so the web page over
    the home network stopped answering until a key was pressed (the page only
    keeps it awake while it is visible on the phone).
    Joined to the home network it now goes into standby first: station stays
    connected and serves the page, the LR-Remote access point is off, modem power
    saving is on and the CPU runs at 80 MHz. A page request restores full speed
    (access point stays off); a key press ends standby. Full sleep follows after
    HOME_STANDBY_MIN (default 120 min; 0 = off, -1 = never sleep on home Wi-Fi).
    Simulator scenario 19 covers the Wi-Fi side. No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
2026-11-11 Screen UI: clearer header and footer, no "< Back" rows, BACK opens the menu
    - Header: battery outlines for the AA pack and the screen cell, an "IR" mark
    while a code goes out, and the network state in a box (AP / WiFi / Standby /
    Asleep). Titles are no longer cut short.
    - Footer: key hints drawn as key caps in a readable size; the last code sent on
    one line with the protocol details small at the right.
    - Lists: "< Back" rows removed (BACK and LEFT already go back); values are
    right-aligned, arrows mark rows that open a screen, rules separate groups.
    Going back lands on the row you came from.
    - Remote screen: the "Menu" tile (easily confused with the device's own Menu
    key) is gone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
    [ST7305_U8g2.h, disp.cpp, main.cpp, script_number_allkeys.h, script_walkthrough.h, sheet.py]
2026-11-11 Discover: find and control devices that are not in the code database
    New engine (discover.cpp), used by the screen and the web page:
    - Sweep: for a protocol family (NEC, NEC extended, Samsung, Sony 12/15, RC5,
    RC6, Panasonic, Pioneer, JVC, Denon, Sharp, Mitsubishi, RCA, Akai, Emerson,
    RECS80, Bose) every device address gets a burst of probe functions - the
    function numbers the database's remotes most often use for Power, Vol + and
    Mute in that protocol. Database addresses go first. ~4 min for NEC, ~35 min
    for everything.
    - Narrow: "it reacted" steps back 3 addresses; the user tries them one by one.
    - Learn: step through the address's functions (most used first, with what each
    usu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
2026-11-11 Remove idle sleep and standby; adjustable Code search auto speed
    The remote now never sleeps: no light sleep, no home-network standby, no
    Wi-Fi suspend/resume. Screen, keys, Wi-Fi and the web page stay on until
    the PWR button switches it off. power.cpp/.h are gone, along with the
    sleep hooks in hw, sound, ui, wifi_mgr and web, the IDLE_SLEEP_S /
    HOME_STANDBY_MIN / WIFI_RESUME_DELAY_MS settings and the "Asleep" /
    "Standby" header states.
    Code search on the web page: Auto now defaults to one code a second
    (was every 3 s), with a selector from 0.5 to 3 s. The choice is
    remembered in the browser, applies at once while Auto runs, and the next
    code waits for the previous send to finish so codes n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
2026-11-11 Web: show incoming requests on the Status screen; speed selector always visible
    - Status screen: a "Web page" line shows when the last request arrived and
    from which address (refreshes every 2 s). The serial log names each new
    client and every page load. This tells a phone whose requests never
    reach the remote apart from a page problem.
    - Code search: "Auto speed" now sits above Start (it was only shown after
    Start, inside the result box).
    - Page requests time out (4 s for key presses, 20 s for lists), so one
    lost request on a flaky phone link can't freeze the keys queued behind it.
    Claude-Session: https://claude.ai/code/sess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
    [script_walkthrough.h, ui.cpp, ui.h, web.cpp]
2026-11-12 Code search Auto on the remote's screen; one shared speed setting
    - Code search screen: DOWN starts / stops Auto, UP changes the speed
    (0.5, 0.75, 1, 1.5, 2, 3 s). OK, LEFT, RIGHT or BACK stop it; it stops
    by itself at the last code. An inverted "AUTO" line shows it running.
    UP no longer steps back (LEFT does), DOWN no longer steps forward.
    - Menu > Code search Auto: LEFT / RIGHT change the speed.
    - The speed is saved on the remote (NVS) and shared with the web page
    (/api/scanauto, "auto" in /api/state) instead of browser storage.
    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
    [config.h, script_walkthrough.h, settings.cpp, settings.h, stubs.cpp, ui.cpp, web.cpp]
2026-11-12 Bluetooth scanner: nearby BLE devices with maker, type, address, signal
    - Menu > Bluetooth scanner and a Bluetooth tab on the web page list the
    BLE devices heard (strongest first, sortable, "gone" after 30 s), with a
    details view: type, brand, detail, name, address kind, MAC maker,
    services, maker data and a live signal meter for finding a device.
    - ble_ident: parses adverts and identifies them from maker data (Apple
    continuity: AirPods/Beats models, Find My, iBeacon, HomeKit, AirPlay...;
    Microsoft CDP and Swift Pair), services (SIG services, company UUIDs,
    Google Find Hub, Eddystone, Tile, Chipolo), appearance, the device name,
    and the MAC prefix for public addresses. Each res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
2026-11-13 Code database: read codes from the SD card; add LIRC, JP1 and SmartIR sources
    Firmware
    - Only the index of irdb.bin (names, brands, groups, remotes: 2.2 MB) is
    loaded into PSRAM. Codes, raw signals and a new per-key index are read
    from the card on demand through a small page cache, so the file is no
    longer limited by memory. File version 3; raw signal numbers are 32-bit.
    - Code search reads the key index (one entry per remote that has the key,
    with a 64-bit signal id) instead of walking every code. For Power,
    remotes with only "On" or only "Off" are included.
    - The transmit task reads raw signals from the card (stack 8 K). Database
    upload and card format close / reopen the databa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
2026-11-14 Web code search: don't read every candidate's name from the card
    With the database on the SD card, /api/scan looked up the name of each
    candidate code: for Power that is 4,021 codes scattered over the 6 MB
    code table, about 2,300 random 4 KB reads (9 MB). That took longer than
    the page's 20 s timeout, so the list never arrived and nothing was sent,
    and the remote was unresponsive meanwhile. The list now comes from the
    index in memory only (41 card reads to build); the page shows the key
    being searched instead of the code's name.
    The card reader also skips the seek when a read continues where the last
    one ended (a seek in a big file walks its cluster chain).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
    [sd_store.cpp, web.cpp]
2026-11-14 Log every IR send (and why one isn't sent); look codes up before queuing
    - Serial log: "IR: sent <label> (<protocol> D S F, Hz) xN in T ms", or
    "IR: not sent: ..." with the reason (LED pack not detected / flat,
    code can't be encoded, raw signal can't be read from the card).
    - "Code search: <key>, N codes to try (T ms)" when a search list is built.
    - A database code's protocol numbers are read by the caller when the key
    is pressed, not by the transmit task, so only raw captures are read
    from the SD card by the transmit task.
    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
2026-11-14 IR: read raw captures when the key is pressed, not in the transmit task
    Card reads from the transmit task failed on the device (database codes
    sent nothing until 937e416 moved the code lookup to the caller). Raw
    captures (many LIRC / JP1 codes) still read their samples there; they are
    now read in post() into one of three slots, with a generation number so a
    slot reused by newer presses is never sent half-overwritten.
    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
    [ir_tx.cpp]
2026-11-14 Remove the Bluetooth scanner
    Opening it locked the remote up. Reverts 971e673: the scanner screens,
    the web Bluetooth tab and /api/ble, ble_* sources, ble_db.h, oui.bin and
    its upload, the BLE tests and tools. Keeps sd_store::loadToPsram, which
    the database code now uses, and the README fixes from that commit.
    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
    [LongRangeRemote.ino, script_walkthrough.h, sd_store.cpp, sd_store.h, stubs.cpp, ui.cpp]
